sfrwmaker/hakko_t12_stm32/Drivers/README

Extract this archive to the Driver folder. This is a u8g2 library for the project
