sfrwmaker/hakko_t12_stm32/F1-T12.handle.png

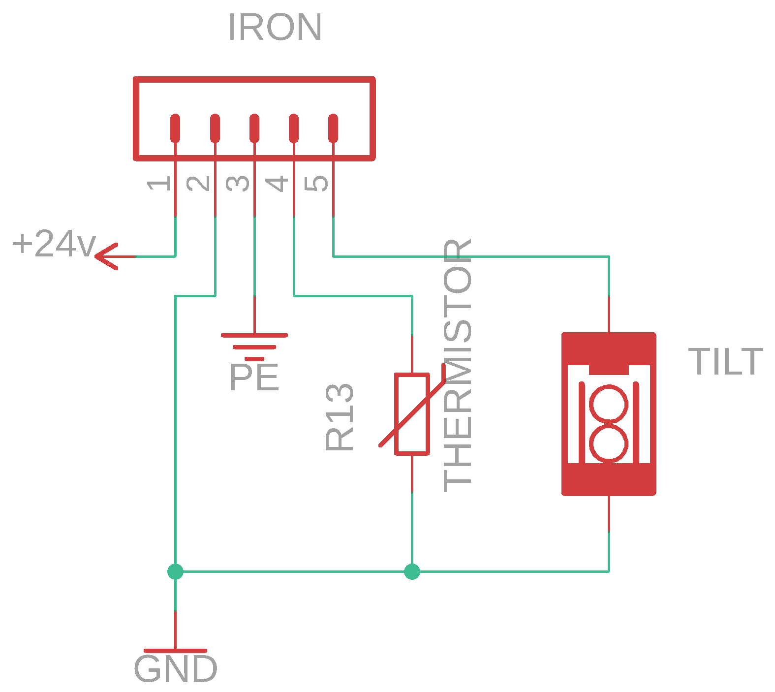
F1-T12.handle.png
