sfrwmaker/hakko_t12_stm32/F1-T12.sensor.png

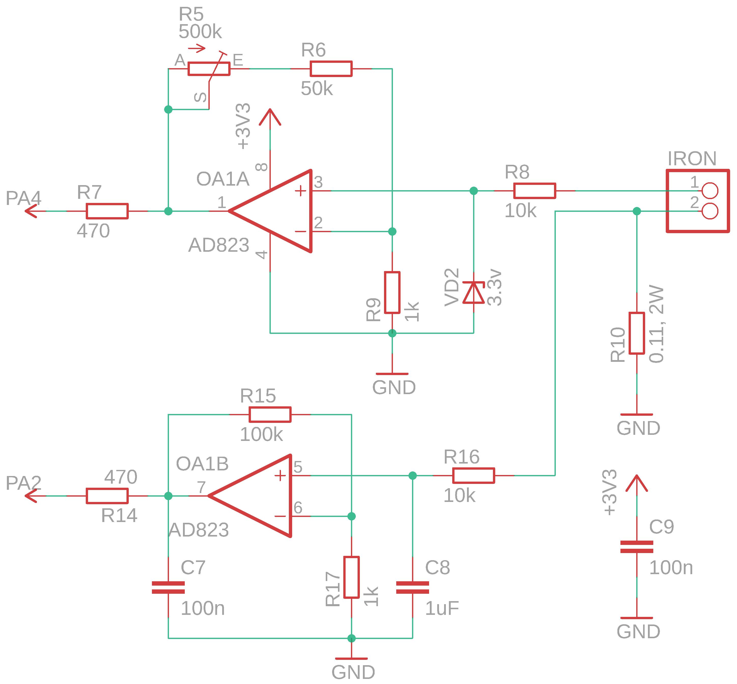
F1-T12.sensor.png
