sfrwmaker/hakko_t12_stm32/F1-T12_nandle.png

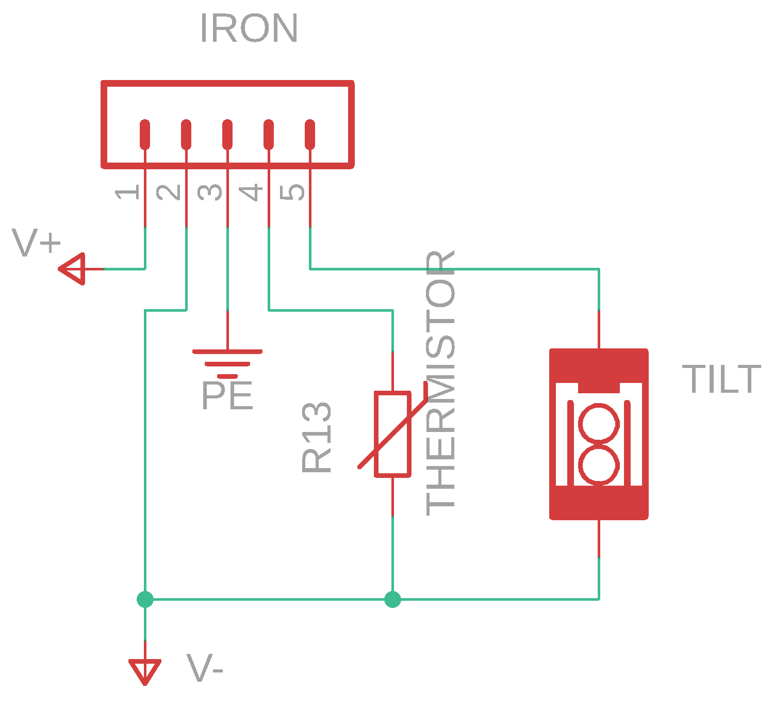
F1-T12_nandle.png
