sfrwmaker/hakko_t12_stm32/F1-T12_sensor.png

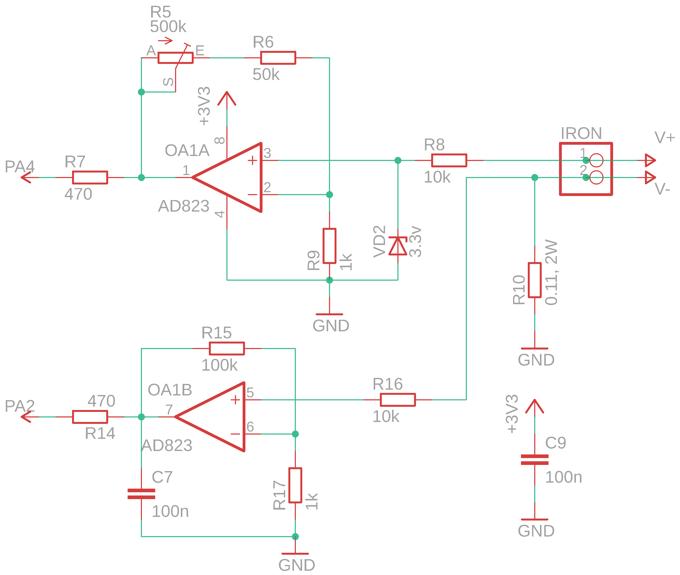
F1-T12_sensor.png
