sfrwmaker/hakko_t12_stm32/v1.0/stm32_hakko_t12_complete.png

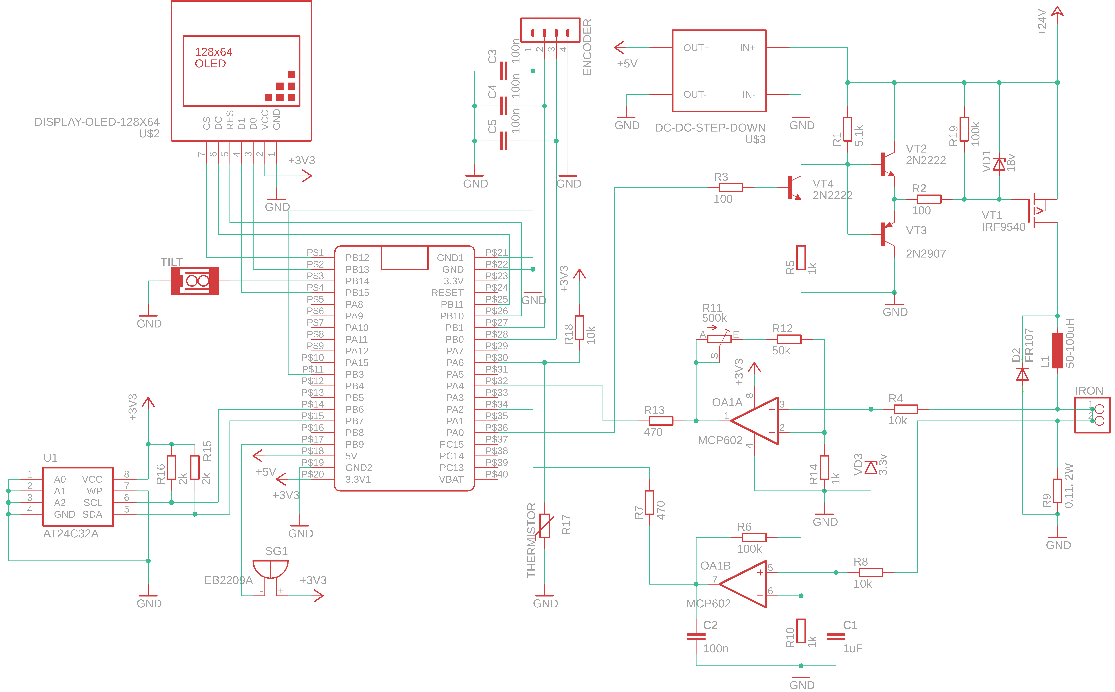
v1.0/stm32_hakko_t12_complete.png
