sfrwmaker/hakko_t12_stm32/(threads)

Thread 1 (2019-01-04):

PCB layout

dodox1, 2019-01-04:
Hello,
do You intend to create/publish PCB for Your project? Can I help with this?

dodo

sfrwmaker, 2019-01-05:
No, i do not intend to create PCB. I would appreciate if you create it.
The main problem is that the schematics is far from ideal one. First, the DC-DC converter should be changed to another one, 24->3.3v and should provide stable power. Second, the op amp should be changed to SMD variant working at 3.3 volts. Finally,  zener diodes vd5 and vd3 should be removed.
As you can see, there are many modification required in the schematics, and  i think it should be prototyped first.

dodox1, 2019-01-05:
Did You see this "china" T12 controller board based on STM32 as inspiration?
There is in a few different HW version (2.1S, 2.01 and 2.0)
Reverse engeniered:
https://github.com/jomat/stm32_soldering_iron_controller/tree/master/schematic

sfrwmaker, 2019-01-05:
Yes, i have one. Cannot tell which version is, but works great. It keeps the preset temperature more accurate than my version, it reaches the temperature faster. I believe, this because of better parameters of PID algorithm. Great, that it has multi-language support. This controller does not use PWM signal to drive the iron, so the schematics is simpler and more compact. Excellent project.
Thank you for the reference.
But this "china" controller has some disadvantages: uses internal clock to show the time (wrongly) and the display is overwhelmed with useless information. The rotary encoder methods are inconvenient: press-and-turn just terrible. There is a red led blinking as iron is powered on.

Thread 2 (2019-01-13):

question about “exponential moving average”

chenli2015, 2019-01-13:
Hi, sfrwmaker,
Thanks for your great work!
Recently, I read your code. I could not understand the “exponential moving average” part.
The following formula is the one get from:
http://www.alglib.net/time-series/moving-average-filter.php
EMA(t) = α·X(t) + (1-α)·EMA(t-1)

but the code from your project is diffrent:
int32_t empAverage(uint32_t *emp_data, uint8_t emp_k, int32_t v) {
  uint8_t round_v = emp_k >> 1;
  *emp_data += v - (*emp_data + round_v) / emp_k;
  return (*emp_data + round_v) / emp_k;
}

Is this a mistake?

sfrwmaker, 2019-01-13:
In the project the recursive variant of the formula is used.

chenli2015, 2019-01-14:
Thanks for your response！ I get the formula from wikipedia.

Closed 2019-01-14.

Thread 3 (2019-12-19):

Recompile, output overflowed

PamiVOV, 2019-12-19:
14:39:16 **** Incremental Build of configuration Release for project F1-T12 ****
make all
arm-none-eabi-g++ -o "F1-T12.elf" @"objects.list"   -mcpu=cortex-m3 -T"../STM32F103C8Tx_FLASH.ld" -Wl,-Map="F1-T12.map" -Wl,--gc-sections -static --specs=nano.specs -mfloat-abi=soft -mthumb -Wl,--start-group -lc -lm -lstdc++ -lsupc++ -Wl,--end-group
c:\st\stm32cubeide_1.0.2\stm32cubeide\plugins\com.st.stm32cube.ide.mcu.externaltools.gnu-tools-for-stm32.7-2018-q2-update.win32_1.0.0.201904181610\tools\arm-none-eabi\bin\ld.exe: F1-T12.elf section `.rodata' will not fit in region `FLASH'
c:\st\stm32cubeide_1.0.2\stm32cubeide\plugins\com.st.stm32cube.ide.mcu.externaltools.gnu-tools-for-stm32.7-2018-q2-update.win32_1.0.0.201904181610\tools\arm-none-eabi\bin\ld.exe: F1-T12.elf section `.bss' will not fit in region `RAM'
c:\st\stm32cubeide_1.0.2\stm32cubeide\plugins\com.st.stm32cube.ide.mcu.externaltools.gnu-tools-for-stm32.7-2018-q2-update.win32_1.0.0.201904181610\tools\arm-none-eabi\bin\ld.exe: region `RAM' overflowed by 115896 bytes
c:\st\stm32cubeide_1.0.2\stm32cubeide\plugins\com.st.stm32cube.ide.mcu.externaltools.gnu-tools-for-stm32.7-2018-q2-update.win32_1.0.0.201904181610\tools\arm-none-eabi\bin\ld.exe: region `FLASH' overflowed by 9253216 bytes
collect2.exe: error: ld returned 1 exit status
make: *** [makefile:60: F1-T12.elf] Error 1
"make all" terminated with exit code 2. Build might be incomplete.

14:39:18 Build Failed. 1 errors, 0 warnings. (took 2s.504ms)

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

sfrwmaker, 2019-12-19:
Optimization options " -ffunction-sections -fdata-sections" should help.
Otherwise, use prebuilt version.

sfrwmaker, 2019-12-19:
Optimization flags should work.

Building file: ../Drivers/u8g2/Src/u8x8_d_lc7981.c
Invoking: MCU GCC Compiler
E:\stm32\F1-T12\Debug
arm-none-eabi-gcc -mcpu=cortex-m3 -mthumb -mfloat-abi=soft '-D__weak=__attribute__((weak))' '-D__packed=__attribute__((__packed__))' -DUSE_HAL_DRIVER -DSTM32F103xB -I"E:/stm32/F1-T12/Inc" -I"E:/stm32/F1-T12/Drivers/u8g2/Inc" -I"E:/stm32/F1-T12/Drivers/STM32F1xx_HAL_Driver/Inc" -I"E:/stm32/F1-T12/Drivers/STM32F1xx_HAL_Driver/Inc/Legacy" -I"E:/stm32/F1-T12/Drivers/CMSIS/Device/ST/STM32F1xx/Include" -I"E:/stm32/F1-T12/Drivers/CMSIS/Include"  -O2 -ffunction-sections -fdata-sections -g3 -Wall -fmessage-length=0 -ffunction-sections -c -fmessage-length=0 -MMD -MP -MF"Drivers/u8g2/Src/u8x8_d_lc7981.d" -MT"Drivers/u8g2/Src/u8x8_d_lc7981.o" -o "Drivers/u8g2/Src/u8x8_d_lc7981.o" "../Drivers/u8g2/Src/u8x8_d_lc7981.c"
Finished building: ../Drivers/u8g2/Src/u8x8_d_lc7981.c

Building file: ../Drivers/u8g2/Src/u8x8_d_ld7032_60x32.c
Invoking: MCU GCC Compiler
E:\stm32\F1-T12\Debug
arm-none-eabi-gcc -mcpu=cortex-m3 -mthumb -mfloat-abi=soft '-D__weak=__attribute__((weak))' '-D__packed=__attribute__((__packed__))' -DUSE_HAL_DRIVER -DSTM32F103xB -I"E:/stm32/F1-T12/Inc" -I"E:/stm32/F1-T12/Drivers/u8g2/Inc" -I"E:/stm32/F1-T12/Drivers/STM32F1xx_HAL_Driver/Inc" -I"E:/stm32/F1-T12/Drivers/STM32F1xx_HAL_Driver/Inc/Legacy" -I"E:/stm32/F1-T12/Drivers/CMSIS/Device/ST/STM32F1xx/Include" -I"E:/stm32/F1-T12/Drivers/CMSIS/Include"  -O2 -ffunction-sections -fdata-sections -g3 -Wall -fmessage-length=0 -ffunction-sections -c -fmessage-length=0 -MMD -MP -MF"Drivers/u8g2/Src/u8x8_d_ld7032_60x32.d" -MT"Drivers/u8g2/Src/u8x8_d_ld7032_60x32.o" -o "Drivers/u8g2/Src/u8x8_d_ld7032_60x32.o" "../Drivers/u8g2/Src/u8x8_d_ld7032_60x32.c"
../Drivers/u8g2/Src/u8x8_d_ld7032_60x32.c:43:22: warning: 'u8x8_d_ld7032_60x32_init_seq_old' defined but not used [-Wunused-const-variable=]
 static const uint8_t u8x8_d_ld7032_60x32_init_seq_old[] = {
                      ^~~~~~~~~~~~~~~~~~~~~~~~~~~~~~~~
Finished building: ../Drivers/u8g2/Src/u8x8_d_ld7032_60x32.c

Building file: ../Drivers/u8g2/Src/u8x8_d_ls013b7dh03.c
Invoking: MCU GCC Compiler
E:\stm32\F1-T12\Debug
arm-none-eabi-gcc -mcpu=cortex-m3 -mthumb -mfloat-abi=soft '-D__weak=__attribute__((weak))' '-D__packed=__attribute__((__packed__))' -DUSE_HAL_DRIVER -DSTM32F103xB -I"E:/stm32/F1-T12/Inc" -I"E:/stm32/F1-T12/Drivers/u8g2/Inc" -I"E:/stm32/F1-T12/Drivers/STM32F1xx_HAL_Driver/Inc" -I"E:/stm32/F1-T12/Drivers/STM32F1xx_HAL_Driver/Inc/Legacy" -I"E:/stm32/F1-T12/Drivers/CMSIS/Device/ST/STM32F1xx/Include" -I"E:/stm32/F1-T12/Drivers/CMSIS/Include"  -O2 -ffunction-sections -fdata-sections -g3 -Wall -fmessage-length=0 -ffunction-sections -c -fmessage-length=0 -MMD -MP -MF"Drivers/u8g2/Src/u8x8_d_ls013b7dh03.d" -MT"Drivers/u8g2/Src/u8x8_d_ls013b7dh03.o" -o "Drivers/u8g2/Src/u8x8_d_ls013b7dh03.o" "../Drivers/u8g2/Src/u8x8_d_ls013b7dh03.c"
Finished building: ../Drivers/u8g2/Src/u8x8_d_ls013b7dh03.c

Building file: ../Drivers/u8g2/Src/u8x8_d_max7219.c
Invoking: MCU GCC Compiler
E:\stm32\F1-T12\Debug
arm-none-eabi-gcc -mcpu=cortex-m3 -mthumb -mfloat-abi=soft '-D__weak=__attribute__((weak))' '-D__packed=__attribute__((__packed__))' -DUSE_HAL_DRIVER -DSTM32F103xB -I"E:/stm32/F1-T12/Inc" -I"E:/stm32/F1-T12/Drivers/u8g2/Inc" -I"E:/stm32/F1-T12/Drivers/STM32F1xx_HAL_Driver/Inc" -I"E:/stm32/F1-T12/Drivers/STM32F1xx_HAL_Driver/Inc/Legacy" -I"E:/stm32/F1-T12/Drivers/CMSIS/Device/ST/STM32F1xx/Include" -I"E:/stm32/F1-T12/Drivers/CMSIS/Include"  -O2 -ffunction-sections -fdata-sections -g3 -Wall -fmessage-length=0 -ffunction-sections -c -fmessage-length=0 -MMD -MP -MF"Drivers/u8g2/Src/u8x8_d_max7219.d" -MT"Drivers/u8g2/Src/u8x8_d_max7219.o" -o "Drivers/u8g2/Src/u8x8_d_max7219.o" "../Drivers/u8g2/Src/u8x8_d_max7219.c"
Finished building: ../Drivers/u8g2/Src/u8x8_d_max7219.c

Building file: ../Drivers/u8g2/Src/u8x8_d_pcd8544_84x48.c
Invoking: MCU GCC Compiler
E:\stm32\F1-T12\Debug
arm-none-eabi-gcc -mcpu=cortex-m3 -mthumb -mfloat-abi=soft '-D__weak=__attribute__((weak))' '-D__packed=__attribute__((__packed__))' -DUSE_HAL_DRIVER -DSTM32F103xB -I"E:/stm32/F1-T12/Inc" -I"E:/stm32/F1-T12/Drivers/u8g2/Inc" -I"E:/stm32/F1-T12/Drivers/STM32F1xx_HAL_Driver/Inc" -I"E:/stm32/F1-T12/Drivers/STM32F1xx_HAL_Driver/Inc/Legacy" -I"E:/stm32/F1-T12/Drivers/CMSIS/Device/ST/STM32F1xx/Include" -I"E:/stm32/F1-T12/Drivers/CMSIS/Include"  -O2 -ffunction-sections -fdata-sections -g3 -Wall -fmessage-length=0 -ffunction-sections -c -fmessage-length=0 -MMD -MP -MF"Drivers/u8g2/Src/u8x8_d_pcd8544_84x48.d" -MT"Drivers/u8g2/Src/u8x8_d_pcd8544_84x48.o" -o "Drivers/u8g2/Src/u8x8_d_pcd8544_84x48.o" "../Drivers/u8g2/Src/u8x8_d_pcd8544_84x48.c"
Finished building: ../Drivers/u8g2/Src/u8x8_d_pcd8544_84x48.c

Building file: ../Drivers/u8g2/Src/u8x8_d_pcf8812.c
Invoking: MCU GCC Compiler
E:\stm32\F1-T12\Debug
arm-none-eabi-gcc -mcpu=cortex-m3 -mthumb -mfloat-abi=soft '-D__weak=__attribute__((weak))' '-D__packed=__attribute__((__packed__))' -DUSE_HAL_DRIVER -DSTM32F103xB -I"E:/stm32/F1-T12/Inc" -I"E:/stm32/F1-T12/Drivers/u8g2/Inc" -I"E:/stm32/F1-T12/Drivers/STM32F1xx_HAL_Driver/Inc" -I"E:/stm32/F1-T12/Drivers/STM32F1xx_HAL_Driver/Inc/Legacy" -I"E:/stm32/F1-T12/Drivers/CMSIS/Device/ST/STM32F1xx/Include" -I"E:/stm32/F1-T12/Drivers/CMSIS/Include"  -O2 -ffunction-sections -fdata-sections -g3 -Wall -fmessage-length=0 -ffunction-sections -c -fmessage-length=0 -MMD -MP -MF"Drivers/u8g2/Src/u8x8_d_pcf8812.d" -MT"Drivers/u8g2/Src/u8x8_d_pcf8812.o" -o "Drivers/u8g2/Src/u8x8_d_pcf8812.o" "../Drivers/u8g2/Src/u8x8_d_pcf8812.c"
Finished building: ../Drivers/u8g2/Src/u8x8_d_pcf8812.c

Building file: ../Drivers/u8g2/Src/u8x8_d_pcf8814_hx1230.c
Invoking: MCU GCC Compiler
E:\stm32\F1-T12\Debug
arm-none-eabi-gcc -mcpu=cortex-m3 -mthumb -mfloat-abi=soft '-D__weak=__attribute__((weak))' '-D__packed=__attribute__((__packed__))' -DUSE_HAL_DRIVER -DSTM32F103xB -I"E:/stm32/F1-T12/Inc" -I"E:/stm32/F1-T12/Drivers/u8g2/Inc" -I"E:/stm32/F1-T12/Drivers/STM32F1xx_HAL_Driver/Inc" -I"E:/stm32/F1-T12/Drivers/STM32F1xx_HAL_Driver/Inc/Legacy" -I"E:/stm32/F1-T12/Drivers/CMSIS/Device/ST/STM32F1xx/Include" -I"E:/stm32/F1-T12/Drivers/CMSIS/Include"  -O2 -ffunction-sections -fdata-sections -g3 -Wall -fmessage-length=0 -ffunction-sections -c -fmessage-length=0 -MMD -MP -MF"Drivers/u8g2/Src/u8x8_d_pcf8814_hx1230.d" -MT"Drivers/u8g2/Src/u8x8_d_pcf8814_hx1230.o" -o "Drivers/u8g2/Src/u8x8_d_pcf8814_hx1230.o" "../Drivers/u8g2/Src/u8x8_d_pcf8814_hx1230.c"
Finished building: ../Drivers/u8g2/Src/u8x8_d_pcf8814_hx1230.c

Building file: ../Drivers/u8g2/Src/u8x8_d_sbn1661.c
Invoking: MCU GCC Compiler
E:\stm32\F1-T12\Debug
arm-none-eabi-gcc -mcpu=cortex-m3 -mthumb -mfloat-abi=soft '-D__weak=__attribute__((weak))' '-D__packed=__attribute__((__packed__))' -DUSE_HAL_DRIVER -DSTM32F103xB -I"E:/stm32/F1-T12/Inc" -I"E:/stm32/F1-T12/Drivers/u8g2/Inc" -I"E:/stm32/F1-T12/Drivers/STM32F1xx_HAL_Driver/Inc" -I"E:/stm32/F1-T12/Drivers/STM32F1xx_HAL_Driver/Inc/Legacy" -I"E:/stm32/F1-T12/Drivers/CMSIS/Device/ST/STM32F1xx/Include" -I"E:/stm32/F1-T12/Drivers/CMSIS/Include"  -O2 -ffunction-sections -fdata-sections -g3 -Wall -fmessage-length=0 -ffunction-sections -c -fmessage-length=0 -MMD -MP -MF"Drivers/u8g2/Src/u8x8_d_sbn1661.d" -MT"Drivers/u8g2/Src/u8x8_d_sbn1661.o" -o "Drivers/u8g2/Src/u8x8_d_sbn1661.o" "../Drivers/u8g2/Src/u8x8_d_sbn1661.c"
Finished building: ../Drivers/u8g2/Src/u8x8_d_sbn1661.c

Building file: ../Drivers/u8g2/Src/u8x8_d_sed1330.c
Invoking: MCU GCC Compiler
E:\stm32\F1-T12\Debug
arm-none-eabi-gcc -mcpu=cortex-m3 -mthumb -mfloat-abi=soft '-D__weak=__attribute__((weak))' '-D__packed=__attribute__((__packed__))' -DUSE_HAL_DRIVER -DSTM32F103xB -I"E:/stm32/F1-T12/Inc" -I"E:/stm32/F1-T12/Drivers/u8g2/Inc" -I"E:/stm32/F1-T12/Drivers/STM32F1xx_HAL_Driver/Inc" -I"E:/stm32/F1-T12/Drivers/STM32F1xx_HAL_Driver/Inc/Legacy" -I"E:/stm32/F1-T12/Drivers/CMSIS/Device/ST/STM32F1xx/Include" -I"E:/stm32/F1-T12/Drivers/CMSIS/Include"  -O2 -ffunction-sections -fdata-sections -g3 -Wall -fmessage-length=0 -ffunction-sections -c -fmessage-length=0 -MMD -MP -MF"Drivers/u8g2/Src/u8x8_d_sed1330.d" -MT"Drivers/u8g2/Src/u8x8_d_sed1330.o" -o "Drivers/u8g2/Src/u8x8_d_sed1330.o" "../Drivers/u8g2/Src/u8x8_d_sed1330.c"
Finished building: ../Drivers/u8g2/Src/u8x8_d_sed1330.c

Building file: ../Drivers/u8g2/Src/u8x8_d_sh1106_64x32.c
Invoking: MCU GCC Compiler
E:\stm32\F1-T12\Debug
arm-none-eabi-gcc -mcpu=cortex-m3 -mthumb -mfloat-abi=soft '-D__weak=__attribute__((weak))' '-D__packed=__attribute__((__packed__))' -DUSE_HAL_DRIVER -DSTM32F103xB -I"E:/stm32/F1-T12/Inc" -I"E:/stm32/F1-T12/Drivers/u8g2/Inc" -I"E:/stm32/F1-T12/Drivers/STM32F1xx_HAL_Driver/Inc" -I"E:/stm32/F1-T12/Drivers/STM32F1xx_HAL_Driver/Inc/Legacy" -I"E:/stm32/F1-T12/Drivers/CMSIS/Device/ST/STM32F1xx/Include" -I"E:/stm32/F1-T12/Drivers/CMSIS/Include"  -O2 -ffunction-sections -fdata-sections -g3 -Wall -fmessage-length=0 -ffunction-sections -c -fmessage-length=0 -MMD -MP -MF"Drivers/u8g2/Src/u8x8_d_sh1106_64x32.d" -MT"Drivers/u8g2/Src/u8x8_d_sh1106_64x32.o" -o "Drivers/u8g2/Src/u8x8_d_sh1106_64x32.o" "../Drivers/u8g2/Src/u8x8_d_sh1106_64x32.c"
Finished building: ../Drivers/u8g2/Src/u8x8_d_sh1106_64x32.c

Building file: ../Drivers/u8g2/Src/u8x8_d_sh1106_72x40.c
Invoking: MCU GCC Compiler
E:\stm32\F1-T12\Debug
arm-none-eabi-gcc -mcpu=cortex-m3 -mthumb -mfloat-abi=soft '-D__weak=__attribute__((weak))' '-D__packed=__attribute__((__packed__))' -DUSE_HAL_DRIVER -DSTM32F103xB -I"E:/stm32/F1-T12/Inc" -I"E:/stm32/F1-T12/Drivers/u8g2/Inc" -I"E:/stm32/F1-T12/Drivers/STM32F1xx_HAL_Driver/Inc" -I"E:/stm32/F1-T12/Drivers/STM32F1xx_HAL_Driver/Inc/Legacy" -I"E:/stm32/F1-T12/Drivers/CMSIS/Device/ST/STM32F1xx/Include" -I"E:/stm32/F1-T12/Drivers/CMSIS/Include"  -O2 -ffunction-sections -fdata-sections -g3 -Wall -fmessage-length=0 -ffunction-sections -c -fmessage-length=0 -MMD -MP -MF"Drivers/u8g2/Src/u8x8_d_sh1106_72x40.d" -MT"Drivers/u8g2/Src/u8x8_d_sh1106_72x40.o" -o "Drivers/u8g2/Src/u8x8_d_sh1106_72x40.o" "../Drivers/u8g2/Src/u8x8_d_sh1106_72x40.c"
Finished building: ../Drivers/u8g2/Src/u8x8_d_sh1106_72x40.c

Building file: ../Drivers/u8g2/Src/u8x8_d_sh1107.c
Invoking: MCU GCC Compiler
E:\stm32\F1-T12\Debug
arm-none-eabi-gcc -mcpu=cortex-m3 -mthumb -mfloat-abi=soft '-D__weak=__attribute__((weak))' '-D__packed=__attribute__((__packed__))' -DUSE_HAL_DRIVER -DSTM32F103xB -I"E:/stm32/F1-T12/Inc" -I"E:/stm32/F1-T12/Drivers/u8g2/Inc" -I"E:/stm32/F1-T12/Drivers/STM32F1xx_HAL_Driver/Inc" -I"E:/stm32/F1-T12/Drivers/STM32F1xx_HAL_Driver/Inc/Legacy" -I"E:/stm32/F1-T12/Drivers/CMSIS/Device/ST/STM32F1xx/Include" -I"E:/stm32/F1-T12/Drivers/CMSIS/Include"  -O2 -ffunction-sections -fdata-sections -g3 -Wall -fmessage-length=0 -ffunction-sections -c -fmessage-length=0 -MMD -MP -MF"Drivers/u8g2/Src/u8x8_d_sh1107.d" -MT"Drivers/u8g2/Src/u8x8_d_sh1107.o" -o "Drivers/u8g2/Src/u8x8_d_sh1107.o" "../Drivers/u8g2/Src/u8x8_d_sh1107.c"
Finished building: ../Drivers/u8g2/Src/u8x8_d_sh1107.c

Building file: ../Drivers/u8g2/Src/u8x8_d_sh1108.c
Invoking: MCU GCC Compiler
E:\stm32\F1-T12\Debug
arm-none-eabi-gcc -mcpu=cortex-m3 -mthumb -mfloat-abi=soft '-D__weak=__attribute__((weak))' '-D__packed=__attribute__((__packed__))' -DUSE_HAL_DRIVER -DSTM32F103xB -I"E:/stm32/F1-T12/Inc" -I"E:/stm32/F1-T12/Drivers/u8g2/Inc" -I"E:/stm32/F1-T12/Drivers/STM32F1xx_HAL_Driver/Inc" -I"E:/stm32/F1-T12/Drivers/STM32F1xx_HAL_Driver/Inc/Legacy" -I"E:/stm32/F1-T12/Drivers/CMSIS/Device/ST/STM32F1xx/Include" -I"E:/stm32/F1-T12/Drivers/CMSIS/Include"  -O2 -ffunction-sections -fdata-sections -g3 -Wall -fmessage-length=0 -ffunction-sections -c -fmessage-length=0 -MMD -MP -MF"Drivers/u8g2/Src/u8x8_d_sh1108.d" -MT"Drivers/u8g2/Src/u8x8_d_sh1108.o" -o "Drivers/u8g2/Src/u8x8_d_sh1108.o" "../Drivers/u8g2/Src/u8x8_d_sh1108.c"
Finished building: ../Drivers/u8g2/Src/u8x8_d_sh1108.c

Building file: ../Drivers/u8g2/Src/u8x8_d_sh1122.c
Invoking: MCU GCC Compiler
E:\stm32\F1-T12\Debug
arm-none-eabi-gcc -mcpu=cortex-m3 -mthumb -mfloat-abi=soft '-D__weak=__attribute__((weak))' '-D__packed=__attribute__((__packed__))' -DUSE_HAL_DRIVER -DSTM32F103xB -I"E:/stm32/F1-T12/Inc" -I"E:/stm32/F1-T12/Drivers/u8g2/Inc" -I"E:/stm32/F1-T12/Drivers/STM32F1xx_HAL_Driver/Inc" -I"E:/stm32/F1-T12/Drivers/STM32F1xx_HAL_Driver/Inc/Legacy" -I"E:/stm32/F1-T12/Drivers/CMSIS/Device/ST/STM32F1xx/Include" -I"E:/stm32/F1-T12/Drivers/CMSIS/Include"  -O2 -ffunction-sections -fdata-sections -g3 -Wall -fmessage-length=0 -ffunction-sections -c -fmessage-length=0 -MMD -MP -MF"Drivers/u8g2/Src/u8x8_d_sh1122.d" -MT"Drivers/u8g2/Src/u8x8_d_sh1122.o" -o "Drivers/u8g2/Src/u8x8_d_sh1122.o" "../Drivers/u8g2/Src/u8x8_d_sh1122.c"
Finished building: ../Drivers/u8g2/Src/u8x8_d_sh1122.c

Building file: ../Drivers/u8g2/Src/u8x8_d_ssd1305.c
Invoking: MCU GCC Compiler
E:\stm32\F1-T12\Debug
arm-none-eabi-gcc -mcpu=cortex-m3 -mthumb -mfloat-abi=soft '-D__weak=__attribute__((weak))' '-D__packed=__attribute__((__packed__))' -DUSE_HAL_DRIVER -DSTM32F103xB -I"E:/stm32/F1-T12/Inc" -I"E:/stm32/F1-T12/Drivers/u8g2/Inc" -I"E:/stm32/F1-T12/Drivers/STM32F1xx_HAL_Driver/Inc" -I"E:/stm32/F1-T12/Drivers/STM32F1xx_HAL_Driver/Inc/Legacy" -I"E:/stm32/F1-T12/Drivers/CMSIS/Device/ST/STM32F1xx/Include" -I"E:/stm32/F1-T12/Drivers/CMSIS/Include"  -O2 -ffunction-sections -fdata-sections -g3 -Wall -fmessage-length=0 -ffunction-sections -c -fmessage-length=0 -MMD -MP -MF"Drivers/u8g2/Src/u8x8_d_ssd1305.d" -MT"Drivers/u8g2/Src/u8x8_d_ssd1305.o" -o "Drivers/u8g2/Src/u8x8_d_ssd1305.o" "../Drivers/u8g2/Src/u8x8_d_ssd1305.c"
Finished building: ../Drivers/u8g2/Src/u8x8_d_ssd1305.c

Building file: ../Drivers/u8g2/Src/u8x8_d_ssd1306_128x32.c
Invoking: MCU GCC Compiler
E:\stm32\F1-T12\Debug
arm-none-eabi-gcc -mcpu=cortex-m3 -mthumb -mfloat-abi=soft '-D__weak=__attribute__((weak))' '-D__packed=__attribute__((__packed__))' -DUSE_HAL_DRIVER -DSTM32F103xB -I"E:/stm32/F1-T12/Inc" -I"E:/stm32/F1-T12/Drivers/u8g2/Inc" -I"E:/stm32/F1-T12/Drivers/STM32F1xx_HAL_Driver/Inc" -I"E:/stm32/F1-T12/Drivers/STM32F1xx_HAL_Driver/Inc/Legacy" -I"E:/stm32/F1-T12/Drivers/CMSIS/Device/ST/STM32F1xx/Include" -I"E:/stm32/F1-T12/Drivers/CMSIS/Include"  -O2 -ffunction-sections -fdata-sections -g3 -Wall -fmessage-length=0 -ffunction-sections -c -fmessage-length=0 -MMD -MP -MF"Drivers/u8g2/Src/u8x8_d_ssd1306_128x32.d" -MT"Drivers/u8g2/Src/u8x8_d_ssd1306_128x32.o" -o "Drivers/u8g2/Src/u8x8_d_ssd1306_128x32.o" "../Drivers/u8g2/Src/u8x8_d_ssd1306_128x32.c"
Finished building: ../Drivers/u8g2/Src/u8x8_d_ssd1306_128x32.c

Building file: ../Drivers/u8g2/Src/u8x8_d_ssd1306_128x64_noname.c
Invoking: MCU GCC Compiler
E:\stm32\F1-T12\Debug
arm-none-eabi-gcc -mcpu=cortex-m3 -mthumb -mfloat-abi=soft '-D__weak=__attribute__((weak))' '-D__packed=__attribute__((__packed__))' -DUSE_HAL_DRIVER -DSTM32F103xB -I"E:/stm32/F1-T12/Inc" -I"E:/stm32/F1-T12/Drivers/u8g2/Inc" -I"E:/stm32/F1-T12/Drivers/STM32F1xx_HAL_Driver/Inc" -I"E:/stm32/F1-T12/Drivers/STM32F1xx_HAL_Driver/Inc/Legacy" -I"E:/stm32/F1-T12/Drivers/CMSIS/Device/ST/STM32F1xx/Include" -I"E:/stm32/F1-T12/Drivers/CMSIS/Include"  -O2 -ffunction-sections -fdata-sections -g3 -Wall -fmessage-length=0 -ffunction-sections -c -fmessage-length=0 -MMD -MP -MF"Drivers/u8g2/Src/u8x8_d_ssd1306_128x64_noname.d" -MT"Drivers/u8g2/Src/u8x8_d_ssd1306_128x64_noname.o" -o "Drivers/u8g2/Src/u8x8_d_ssd1306_128x64_noname.o" "../Drivers/u8g2/Src/u8x8_d_ssd1306_128x64_noname.c"
Finished building: ../Drivers/u8g2/Src/u8x8_d_ssd1306_128x64_noname.c

Building file: ../Drivers/u8g2/Src/u8x8_d_ssd1306_48x64.c
Invoking: MCU GCC Compiler
E:\stm32\F1-T12\Debug
arm-none-eabi-gcc -mcpu=cortex-m3 -mthumb -mfloat-abi=soft '-D__weak=__attribute__((weak))' '-D__packed=__attribute__((__packed__))' -DUSE_HAL_DRIVER -DSTM32F103xB -I"E:/stm32/F1-T12/Inc" -I"E:/stm32/F1-T12/Drivers/u8g2/Inc" -I"E:/stm32/F1-T12/Drivers/STM32F1xx_HAL_Driver/Inc" -I"E:/stm32/F1-T12/Drivers/STM32F1xx_HAL_Driver/Inc/Legacy" -I"E:/stm32/F1-T12/Drivers/CMSIS/Device/ST/STM32F1xx/Include" -I"E:/stm32/F1-T12/Drivers/CMSIS/Include"  -O2 -ffunction-sections -fdata-sections -g3 -Wall -fmessage-length=0 -ffunction-sections -c -fmessage-length=0 -MMD -MP -MF"Drivers/u8g2/Src/u8x8_d_ssd1306_48x64.d" -MT"Drivers/u8g2/Src/u8x8_d_ssd1306_48x64.o" -o "Drivers/u8g2/Src/u8x8_d_ssd1306_48x64.o" "../Drivers/u8g2/Src/u8x8_d_ssd1306_48x64.c"
Finished building: ../Drivers/u8g2/Src/u8x8_d_ssd1306_48x64.c

Building file: ../Drivers/u8g2/Src/u8x8_d_ssd1306_64x32.c
Invoking: MCU GCC Compiler
E:\stm32\F1-T12\Debug
arm-none-eabi-gcc -mcpu=cortex-m3 -mthumb -mfloat-abi=soft '-D__weak=__attribute__((weak))' '-D__packed=__attribute__((__packed__))' -DUSE_HAL_DRIVER -DSTM32F103xB -I"E:/stm32/F1-T12/Inc" -I"E:/stm32/F1-T12/Drivers/u8g2/Inc" -I"E:/stm32/F1-T12/Drivers/STM32F1xx_HAL_Driver/Inc" -I"E:/stm32/F1-T12/Drivers/STM32F1xx_HAL_Driver/Inc/Legacy" -I"E:/stm32/F1-T12/Drivers/CMSIS/Device/ST/STM32F1xx/Include" -I"E:/stm32/F1-T12/Drivers/CMSIS/Include"  -O2 -ffunction-sections -fdata-sections -g3 -Wall -fmessage-length=0 -ffunction-sections -c -fmessage-length=0 -MMD -MP -MF"Drivers/u8g2/Src/u8x8_d_ssd1306_64x32.d" -MT"Drivers/u8g2/Src/u8x8_d_ssd1306_64x32.o" -o "Drivers/u8g2/Src/u8x8_d_ssd1306_64x32.o" "../Drivers/u8g2/Src/u8x8_d_ssd1306_64x32.c"
Finished building: ../Drivers/u8g2/Src/u8x8_d_ssd1306_64x32.c

Building file: ../Drivers/u8g2/Src/u8x8_d_ssd1306_64x48.c
Invoking: MCU GCC Compiler
E:\stm32\F1-T12\Debug
arm-none-eabi-gcc -mcpu=cortex-m3 -mthumb -mfloat-abi=soft '-D__weak=__attribute__((weak))' '-D__packed=__attribute__((__packed__))' -DUSE_HAL_DRIVER -DSTM32F103xB -I"E:/stm32/F1-T12/Inc" -I"E:/stm32/F1-T12/Drivers/u8g2/Inc" -I"E:/stm32/F1-T12/Drivers/STM32F1xx_HAL_Driver/Inc" -I"E:/stm32/F1-T12/Drivers/STM32F1xx_HAL_Driver/Inc/Legacy" -I"E:/stm32/F1-T12/Drivers/CMSIS/Device/ST/STM32F1xx/Include" -I"E:/stm32/F1-T12/Drivers/CMSIS/Include"  -O2 -ffunction-sections -fdata-sections -g3 -Wall -fmessage-length=0 -ffunction-sections -c -fmessage-length=0 -MMD -MP -MF"Drivers/u8g2/Src/u8x8_d_ssd1306_64x48.d" -MT"Drivers/u8g2/Src/u8x8_d_ssd1306_64x48.o" -o "Drivers/u8g2/Src/u8x8_d_ssd1306_64x48.o" "../Drivers/u8g2/Src/u8x8_d_ssd1306_64x48.c"
Finished building: ../Drivers/u8g2/Src/u8x8_d_ssd1306_64x48.c

Building file: ../Drivers/u8g2/Src/u8x8_d_ssd1306_96x16.c
Invoking: MCU GCC Compiler
E:\stm32\F1-T12\Debug
arm-none-eabi-gcc -mcpu=cortex-m3 -mthumb -mfloat-abi=soft '-D__weak=__attribute__((weak))' '-D__packed=__attribute__((__packed__))' -DUSE_HAL_DRIVER -DSTM32F103xB -I"E:/stm32/F1-T12/Inc" -I"E:/stm32/F1-T12/Drivers/u8g2/Inc" -I"E:/stm32/F1-T12/Drivers/STM32F1xx_HAL_Driver/Inc" -I"E:/stm32/F1-T12/Drivers/STM32F1xx_HAL_Driver/Inc/Legacy" -I"E:/stm32/F1-T12/Drivers/CMSIS/Device/ST/STM32F1xx/Include" -I"E:/stm32/F1-T12/Drivers/CMSIS/Include"  -O2 -ffunction-sections -fdata-sections -g3 -Wall -fmessage-length=0 -ffunction-sections -c -fmessage-length=0 -MMD -MP -MF"Drivers/u8g2/Src/u8x8_d_ssd1306_96x16.d" -MT"Drivers/u8g2/Src/u8x8_d_ssd1306_96x16.o" -o "Drivers/u8g2/Src/u8x8_d_ssd1306_96x16.o" "../Drivers/u8g2/Src/u8x8_d_ssd1306_96x16.c"
Finished building: ../Drivers/u8g2/Src/u8x8_d_ssd1306_96x16.c

Building file: ../Drivers/u8g2/Src/u8x8_d_ssd1309.c
Invoking: MCU GCC Compiler
E:\stm32\F1-T12\Debug
arm-none-eabi-gcc -mcpu=cortex-m3 -mthumb -mfloat-abi=soft '-D__weak=__attribute__((weak))' '-D__packed=__attribute__((__packed__))' -DUSE_HAL_DRIVER -DSTM32F103xB -I"E:/stm32/F1-T12/Inc" -I"E:/stm32/F1-T12/Drivers/u8g2/Inc" -I"E:/stm32/F1-T12/Drivers/STM32F1xx_HAL_Driver/Inc" -I"E:/stm32/F1-T12/Drivers/STM32F1xx_HAL_Driver/Inc/Legacy" -I"E:/stm32/F1-T12/Drivers/CMSIS/Device/ST/STM32F1xx/Include" -I"E:/stm32/F1-T12/Drivers/CMSIS/Include"  -O2 -ffunction-sections -fdata-sections -g3 -Wall -fmessage-length=0 -ffunction-sections -c -fmessage-length=0 -MMD -MP -MF"Drivers/u8g2/Src/u8x8_d_ssd1309.d" -MT"Drivers/u8g2/Src/u8x8_d_ssd1309.o" -o "Drivers/u8g2/Src/u8x8_d_ssd1309.o" "../Drivers/u8g2/Src/u8x8_d_ssd1309.c"
Finished building: ../Drivers/u8g2/Src/u8x8_d_ssd1309.c

Building file: ../Drivers/u8g2/Src/u8x8_d_ssd1316.c
Invoking: MCU GCC Compiler
E:\stm32\F1-T12\Debug
arm-none-eabi-gcc -mcpu=cortex-m3 -mthumb -mfloat-abi=soft '-D__weak=__attribute__((weak))' '-D__packed=__attribute__((__packed__))' -DUSE_HAL_DRIVER -DSTM32F103xB -I"E:/stm32/F1-T12/Inc" -I"E:/stm32/F1-T12/Drivers/u8g2/Inc" -I"E:/stm32/F1-T12/Drivers/STM32F1xx_HAL_Driver/Inc" -I"E:/stm32/F1-T12/Drivers/STM32F1xx_HAL_Driver/Inc/Legacy" -I"E:/stm32/F1-T12/Drivers/CMSIS/Device/ST/STM32F1xx/Include" -I"E:/stm32/F1-T12/Drivers/CMSIS/Include"  -O2 -ffunction-sections -fdata-sections -g3 -Wall -fmessage-length=0 -ffunction-sections -c -fmessage-length=0 -MMD -MP -MF"Drivers/u8g2/Src/u8x8_d_ssd1316.d" -MT"Drivers/u8g2/Src/u8x8_d_ssd1316.o" -o "Drivers/u8g2/Src/u8x8_d_ssd1316.o" "../Drivers/u8g2/Src/u8x8_d_ssd1316.c"
Finished building: ../Drivers/u8g2/Src/u8x8_d_ssd1316.c

Building file: ../Drivers/u8g2/Src/u8x8_d_ssd1317.c
Invoking: MCU GCC Compiler
E:\stm32\F1-T12\Debug
arm-none-eabi-gcc -mcpu=cortex-m3 -mthumb -mfloat-abi=soft '-D__weak=__attribute__((weak))' '-D__packed=__attribute__((__packed__))' -DUSE_HAL_DRIVER -DSTM32F103xB -I"E:/stm32/F1-T12/Inc" -I"E:/stm32/F1-T12/Drivers/u8g2/Inc" -I"E:/stm32/F1-T12/Drivers/STM32F1xx_HAL_Driver/Inc" -I"E:/stm32/F1-T12/Drivers/STM32F1xx_HAL_Driver/Inc/Legacy" -I"E:/stm32/F1-T12/Drivers/CMSIS/Device/ST/STM32F1xx/Include" -I"E:/stm32/F1-T12/Drivers/CMSIS/Include"  -O2 -ffunction-sections -fdata-sections -g3 -Wall -fmessage-length=0 -ffunction-sections -c -fmessage-length=0 -MMD -MP -MF"Drivers/u8g2/Src/u8x8_d_ssd1317.d" -MT"Drivers/u8g2/Src/u8x8_d_ssd1317.o" -o "Drivers/u8g2/Src/u8x8_d_ssd1317.o" "../Drivers/u8g2/Src/u8x8_d_ssd1317.c"
Finished building: ../Drivers/u8g2/Src/u8x8_d_ssd1317.c

Building file: ../Drivers/u8g2/Src/u8x8_d_ssd1318.c
Invoking: MCU GCC Compiler
E:\stm32\F1-T12\Debug
arm-none-eabi-gcc -mcpu=cortex-m3 -mthumb -mfloat-abi=soft '-D__weak=__attribute__((weak))' '-D__packed=__attribute__((__packed__))' -DUSE_HAL_DRIVER -DSTM32F103xB -I"E:/stm32/F1-T12/Inc" -I"E:/stm32/F1-T12/Drivers/u8g2/Inc" -I"E:/stm32/F1-T12/Drivers/STM32F1xx_HAL_Driver/Inc" -I"E:/stm32/F1-T12/Drivers/STM32F1xx_HAL_Driver/Inc/Legacy" -I"E:/stm32/F1-T12/Drivers/CMSIS/Device/ST/STM32F1xx/Include" -I"E:/stm32/F1-T12/Drivers/CMSIS/Include"  -O2 -ffunction-sections -fdata-sections -g3 -Wall -fmessage-length=0 -ffunction-sections -c -fmessage-length=0 -MMD -MP -MF"Drivers/u8g2/Src/u8x8_d_ssd1318.d" -MT"Drivers/u8g2/Src/u8x8_d_ssd1318.o" -o "Drivers/u8g2/Src/u8x8_d_ssd1318.o" "../Drivers/u8g2/Src/u8x8_d_ssd1318.c"
Finished building: ../Drivers/u8g2/Src/u8x8_d_ssd1318.c

Building file: ../Drivers/u8g2/Src/u8x8_d_ssd1322.c
Invoking: MCU GCC Compiler
E:\stm32\F1-T12\Debug
arm-none-eabi-gcc -mcpu=cortex-m3 -mthumb -mfloat-abi=soft '-D__weak=__attribute__((weak))' '-D__packed=__attribute__((__packed__))' -DUSE_HAL_DRIVER -DSTM32F103xB -I"E:/stm32/F1-T12/Inc" -I"E:/stm32/F1-T12/Drivers/u8g2/Inc" -I"E:/stm32/F1-T12/Drivers/STM32F1xx_HAL_Driver/Inc" -I"E:/stm32/F1-T12/Drivers/STM32F1xx_HAL_Driver/Inc/Legacy" -I"E:/stm32/F1-T12/Drivers/CMSIS/Device/ST/STM32F1xx/Include" -I"E:/stm32/F1-T12/Drivers/CMSIS/Include"  -O2 -ffunction-sections -fdata-sections -g3 -Wall -fmessage-length=0 -ffunction-sections -c -fmessage-length=0 -MMD -MP -MF"Drivers/u8g2/Src/u8x8_d_ssd1322.d" -MT"Drivers/u8g2/Src/u8x8_d_ssd1322.o" -o "Drivers/u8g2/Src/u8x8_d_ssd1322.o" "../Drivers/u8g2/Src/u8x8_d_ssd1322.c"
Finished building: ../Drivers/u8g2/Src/u8x8_d_ssd1322.c

Building file: ../Drivers/u8g2/Src/u8x8_d_ssd1325.c
Invoking: MCU GCC Compiler
E:\stm32\F1-T12\Debug
arm-none-eabi-gcc -mcpu=cortex-m3 -mthumb -mfloat-abi=soft '-D__weak=__attribute__((weak))' '-D__packed=__attribute__((__packed__))' -DUSE_HAL_DRIVER -DSTM32F103xB -I"E:/stm32/F1-T12/Inc" -I"E:/stm32/F1-T12/Drivers/u8g2/Inc" -I"E:/stm32/F1-T12/Drivers/STM32F1xx_HAL_Driver/Inc" -I"E:/stm32/F1-T12/Drivers/STM32F1xx_HAL_Driver/Inc/Legacy" -I"E:/stm32/F1-T12/Drivers/CMSIS/Device/ST/STM32F1xx/Include" -I"E:/stm32/F1-T12/Drivers/CMSIS/Include"  -O2 -ffunction-sections -fdata-sections -g3 -Wall -fmessage-length=0 -ffunction-sections -c -fmessage-length=0 -MMD -MP -MF"Drivers/u8g2/Src/u8x8_d_ssd1325.d" -MT"Drivers/u8g2/Src/u8x8_d_ssd1325.o" -o "Drivers/u8g2/Src/u8x8_d_ssd1325.o" "../Drivers/u8g2/Src/u8x8_d_ssd1325.c"
Finished building: ../Drivers/u8g2/Src/u8x8_d_ssd1325.c

Building file: ../Drivers/u8g2/Src/u8x8_d_ssd1326.c
Invoking: MCU GCC Compiler
E:\stm32\F1-T12\Debug
arm-none-eabi-gcc -mcpu=cortex-m3 -mthumb -mfloat-abi=soft '-D__weak=__attribute__((weak))' '-D__packed=__attribute__((__packed__))' -DUSE_HAL_DRIVER -DSTM32F103xB -I"E:/stm32/F1-T12/Inc" -I"E:/stm32/F1-T12/Drivers/u8g2/Inc" -I"E:/stm32/F1-T12/Drivers/STM32F1xx_HAL_Driver/Inc" -I"E:/stm32/F1-T12/Drivers/STM32F1xx_HAL_Driver/Inc/Legacy" -I"E:/stm32/F1-T12/Drivers/CMSIS/Device/ST/STM32F1xx/Include" -I"E:/stm32/F1-T12/Drivers/CMSIS/Include"  -O2 -ffunction-sections -fdata-sections -g3 -Wall -fmessage-length=0 -ffunction-sections -c -fmessage-length=0 -MMD -MP -MF"Drivers/u8g2/Src/u8x8_d_ssd1326.d" -MT"Drivers/u8g2/Src/u8x8_d_ssd1326.o" -o "Drivers/u8g2/Src/u8x8_d_ssd1326.o" "../Drivers/u8g2/Src/u8x8_d_ssd1326.c"
Finished building: ../Drivers/u8g2/Src/u8x8_d_ssd1326.c

Building file: ../Drivers/u8g2/Src/u8x8_d_ssd1327.c
Invoking: MCU GCC Compiler
E:\stm32\F1-T12\Debug
arm-none-eabi-gcc -mcpu=cortex-m3 -mthumb -mfloat-abi=soft '-D__weak=__attribute__((weak))' '-D__packed=__attribute__((__packed__))' -DUSE_HAL_DRIVER -DSTM32F103xB -I"E:/stm32/F1-T12/Inc" -I"E:/stm32/F1-T12/Drivers/u8g2/Inc" -I"E:/stm32/F1-T12/Drivers/STM32F1xx_HAL_Driver/Inc" -I"E:/stm32/F1-T12/Drivers/STM32F1xx_HAL_Driver/Inc/Legacy" -I"E:/stm32/F1-T12/Drivers/CMSIS/Device/ST/STM32F1xx/Include" -I"E:/stm32/F1-T12/Drivers/CMSIS/Include"  -O2 -ffunction-sections -fdata-sections -g3 -Wall -fmessage-length=0 -ffunction-sections -c -fmessage-length=0 -MMD -MP -MF"Drivers/u8g2/Src/u8x8_d_ssd1327.d" -MT"Drivers/u8g2/Src/u8x8_d_ssd1327.o" -o "Drivers/u8g2/Src/u8x8_d_ssd1327.o" "../Drivers/u8g2/Src/u8x8_d_ssd1327.c"
Finished building: ../Drivers/u8g2/Src/u8x8_d_ssd1327.c

Building file: ../Drivers/u8g2/Src/u8x8_d_ssd1329.c
Invoking: MCU GCC Compiler
E:\stm32\F1-T12\Debug
arm-none-eabi-gcc -mcpu=cortex-m3 -mthumb -mfloat-abi=soft '-D__weak=__attribute__((weak))' '-D__packed=__attribute__((__packed__))' -DUSE_HAL_DRIVER -DSTM32F103xB -I"E:/stm32/F1-T12/Inc" -I"E:/stm32/F1-T12/Drivers/u8g2/Inc" -I"E:/stm32/F1-T12/Drivers/STM32F1xx_HAL_Driver/Inc" -I"E:/stm32/F1-T12/Drivers/STM32F1xx_HAL_Driver/Inc/Legacy" -I"E:/stm32/F1-T12/Drivers/CMSIS/Device/ST/STM32F1xx/Include" -I"E:/stm32/F1-T12/Drivers/CMSIS/Include"  -O2 -ffunction-sections -fdata-sections -g3 -Wall -fmessage-length=0 -ffunction-sections -c -fmessage-length=0 -MMD -MP -MF"Drivers/u8g2/Src/u8x8_d_ssd1329.d" -MT"Drivers/u8g2/Src/u8x8_d_ssd1329.o" -o "Drivers/u8g2/Src/u8x8_d_ssd1329.o" "../Drivers/u8g2/Src/u8x8_d_ssd1329.c"
Finished building: ../Drivers/u8g2/Src/u8x8_d_ssd1329.c

Building file: ../Drivers/u8g2/Src/u8x8_d_ssd1606_172x72.c
Invoking: MCU GCC Compiler
E:\stm32\F1-T12\Debug
arm-none-eabi-gcc -mcpu=cortex-m3 -mthumb -mfloat-abi=soft '-D__weak=__attribute__((weak))' '-D__packed=__attribute__((__packed__))' -DUSE_HAL_DRIVER -DSTM32F103xB -I"E:/stm32/F1-T12/Inc" -I"E:/stm32/F1-T12/Drivers/u8g2/Inc" -I"E:/stm32/F1-T12/Drivers/STM32F1xx_HAL_Driver/Inc" -I"E:/stm32/F1-T12/Drivers/STM32F1xx_HAL_Driver/Inc/Legacy" -I"E:/stm32/F1-T12/Drivers/CMSIS/Device/ST/STM32F1xx/Include" -I"E:/stm32/F1-T12/Drivers/CMSIS/Include"  -O2 -ffunction-sections -fdata-sections -g3 -Wall -fmessage-length=0 -ffunction-sections -c -fmessage-length=0 -MMD -MP -MF"Drivers/u8g2/Src/u8x8_d_ssd1606_172x72.d" -MT"Drivers/u8g2/Src/u8x8_d_ssd1606_172x72.o" -o "Drivers/u8g2/Src/u8x8_d_ssd1606_172x72.o" "../Drivers/u8g2/Src/u8x8_d_ssd1606_172x72.c"
Finished building: ../Drivers/u8g2/Src/u8x8_d_ssd1606_172x72.c

Building file:
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

Thread 4 (2020-05-17):

The temperature stability is not very good

daohuaxiang4, 2020-05-17:
1，Hello, I can not find the ad823 chip with lm358 instead of poor temperature stability after the need to adjust the pid parameters or should use the ad823 chip
2，Some of the cores make noise when they work

sfrwmaker, 2020-05-17:
Hello!
1. l358 is not an analog of ad822. If the lm358 was good for this i would put it itno the schematics, The magic is that lm358 is working like random generator and the controller become instable.
2. Noise will be vanished as soon as you use accurate op-amp. It is a magic. :)

daohuaxiang4, 2020-05-17:
Thank you very much for your answer. I'll try another IC

Thread 5 (2024-01-13):

please add IR Remote control for t12!

myvcgit, 2024-01-13:
i have IR Remote and connect receivers to pb5.
please add IR Remote control for this project.
thank you!!!

the IR Remote can fast change temperature。
if  key 1 set  250 degree ,key 2 set  300 degree,key 3 set 350,key 4 set 400.
press key can fast set 250 to 400 or other.

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
