sfrwmaker/hakko_t12_stm32/eagle/F1-T12_complete.sch

## EAGLE design eagle/F1-T12_complete.sch (2021-02-28)

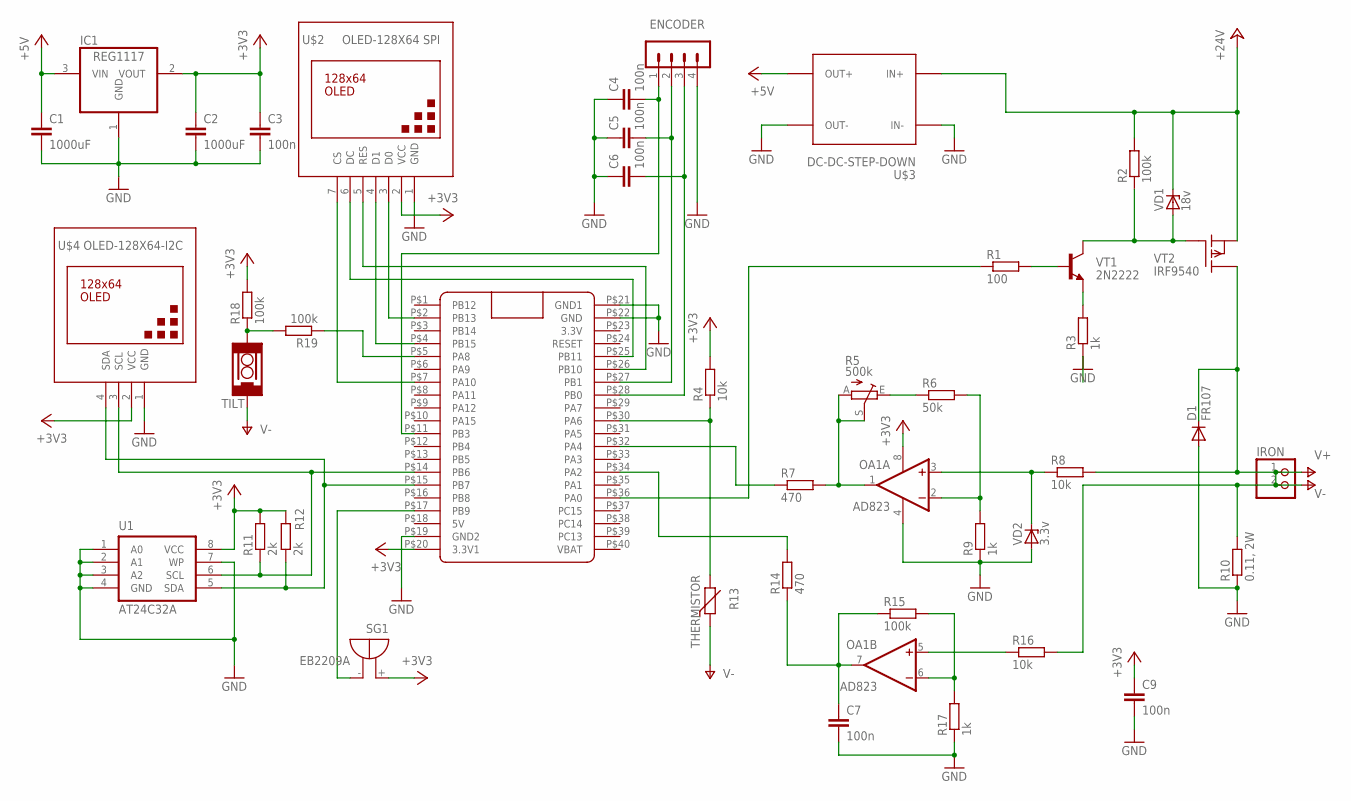
[picture p11: schematic F1-T12_complete.sch]

Parts:
C1, C2: 1000uF; C025-025X050
C3, C4, C5, C6, C7, C9: 100n; C025-025X050
D1: FR107; DO41-10
ENCODER: MA04-1
IC1: REG1117; SOT223
IRON: PINHD-1X2; 1X02
OA1: AD823; SO08
R1: 100; 0204/5
R2, R15, R18, R19: 100k; 0204/5
R3, R9, R17: 1k; 0204/5
R4, R8, R16: 10k; 0204/5
R5: 500k; RJ9W
R6: 50k; 0204/5
R7, R14: 470; 0204/5
R10: 0.11, 2W; 0204/5
R11, R12: 2k; 0204/5
R13: THERMISTOR; RS-2,5
SG1: EB2209A
TILT: SQ-SEN-200
U1: AT24C32A; SO08-8S1
U$1: BLUE_PILL
U$2: OLED-128X64 SPI; DISPLAY-OLED-128X64
U$3: DC-DC-STEP-DOWN; DC-DC-STEP-DOWN-MP2307
U$4: OLED-128X64-I2C; DISPLAY-OLED-128X64-I2C
VD1: 18v; DO34Z7
VD2: 3.3v; DO34Z7
VT1: 2N2222; TO18
VT2: IRF9540; TO220

Connections:
+3V3: C2.1, C3.1, C9.1, IC1.2 (VOUT), OA1.8 (V+), R4.2, R11.2, R12.2, R18.2, SG1.+, U1.8 (VCC), U$1.P$20 (3.3V1), U$2.2 (VCC), U$4.2 (VCC)
+5V: C1.1, IC1.3 (VIN), U$3.OUT+
+24V: R2.2, U$3.IN+, VD1.C, VT2.3 (S)
GND: C1.2, C2.2, C3.2, C4.1, C5.1, C6.1, C7.2, C9.2, D1.A, ENCODER.4, IC1.1 (GND), R3.1, R10.1, R17.1, U1.1 (A0), U1.2 (A1), U1.3 (A2), U1.4 (GND), U1.7 (WP), U$1.P$19 (GND2), U$1.P$21 (GND1), U$1.P$22 (GND), U$2.1 (GND), U$3.IN-, U$3.OUT-, U$4.1 (GND)
unnamed: R12.1, U1.5 (SDA), U$1.P$15 (PB7), U$4.4 (SDA)
unnamed: R11.1, U1.6 (SCL), U$1.P$14 (PB6), U$4.3 (SCL)
unnamed: U$1.P$7 (PA10), U$2.7 (CS)
unnamed: U$1.P$25 (PB11), U$2.6 (DC)
unnamed: U$1.P$26 (PB10), U$2.5 (RES)
unnamed: U$1.P$4 (PB15), U$2.4 (D1)
unnamed: U$1.P$2 (PB13), U$2.3 (D0)
unnamed: SG1.-, U$1.P$17 (PB9)
unnamed: C6.2, ENCODER.3, U$1.P$28 (PB0)
unnamed: C5.2, ENCODER.2, U$1.P$27 (PB1)
unnamed: C4.2, ENCODER.1, U$1.P$11 (PB3)
unnamed: R5.E, R6.1
unnamed: R7.1, U$1.P$32 (PA4)
unnamed: OA1.2 (-IN), R6.2, R9.2
unnamed: OA1.3 (+IN), R8.1, VD2.C
unnamed: R19.1, U$1.P$5 (PA8)
unnamed: C7.1, OA1.7 (OUT), R14.1, R15.1
unnamed: OA1.6 (-IN), R15.2, R17.2
unnamed: OA1.1 (OUT), R5.A, R5.S, R7.2
unnamed: R14.2, U$1.P$34 (PA2)
unnamed: OA1.5 (+IN), R16.1
unnamed: R2.1, VD1.A, VT1.3 (C), VT2.1 (G)
unnamed: R18.1, R19.2, TILT.2
unnamed: R3.2, VT1.1 (E)
unnamed: R1.2, VT1.2 (B)
unnamed: R1.1, U$1.P$36 (PA0)
unnamed: R4.1, R13.2, U$1.P$30 (PA6)
V-: D1.C, IRON.1, IRON.2, R8.2, R10.2, R13.1, R16.2, TILT.1, VT2.2 (D)
VD3: OA1.4 (V-), R9.1, VD2.A
