sfrwmaker/hakko_t12_stm32/eagle/F1-T12_heater.sch

## EAGLE design eagle/F1-T12_heater.sch (2021-02-28)

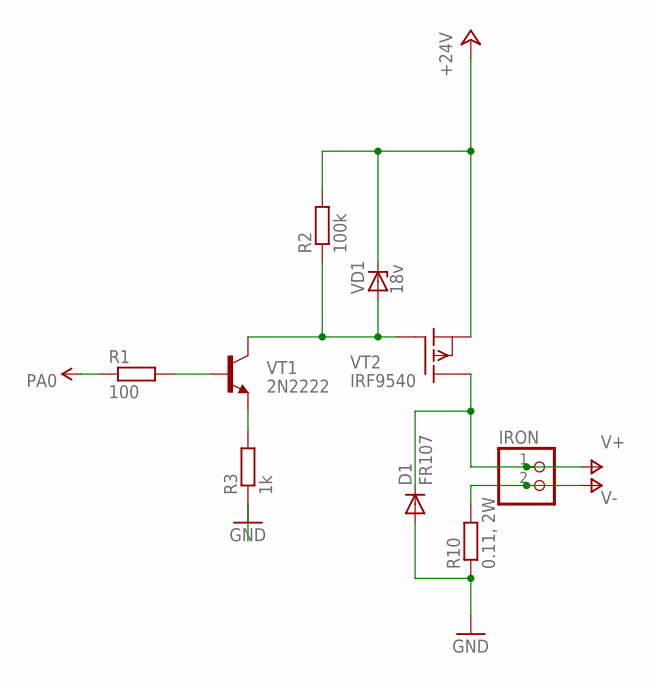
[picture p12: schematic F1-T12_heater.sch]

Parts:
D1: FR107; DO41-10
IRON: PINHD-1X2; 1X02
R1: 100; 0204/5
R2: 100k; 0204/5
R3: 1k; 0204/5
R10: 0.11, 2W; 0204/5
VD1: 18v; DO34Z7
VT1: 2N2222; TO18
VT2: IRF9540; TO220

Connections:
+24V: R2.2, VD1.C, VT2.3 (S)
GND: D1.A, R3.1, R10.1
unnamed: R2.1, VD1.A, VT1.3 (C), VT2.1 (G)
unnamed: R3.2, VT1.1 (E)
unnamed: R1.2, VT1.2 (B)
V+: D1.C, IRON.1, VT2.2 (D)
V-: IRON.2, R10.2
VDD: R1.1
