sfrwmaker/hakko_t12_stm32/eagle/F1-T12_sensor.sch

## EAGLE design eagle/F1-T12_sensor.sch (2021-02-28)

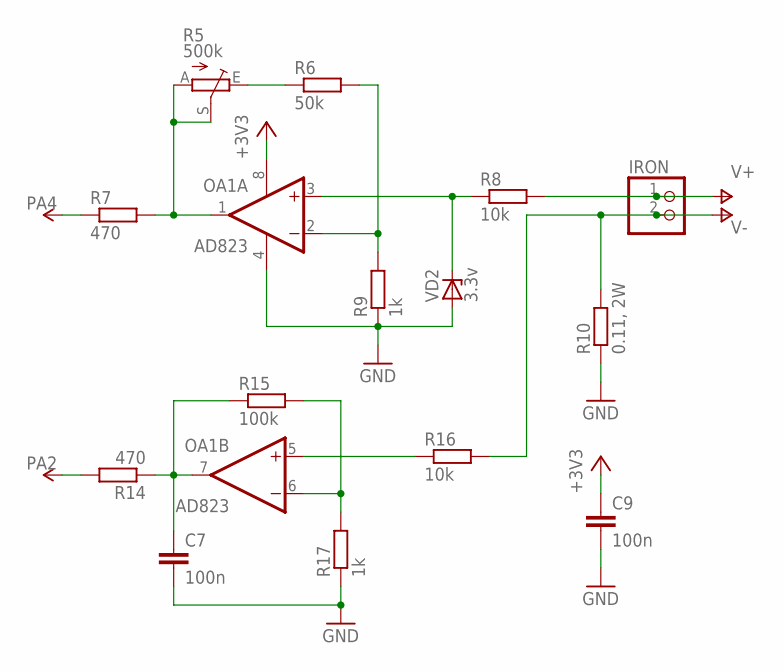
[picture p13: schematic F1-T12_sensor.sch]

Parts:
C7, C9: 100n; C025-025X050
IRON: PINHD-1X2; 1X02
OA1: AD823; SO08
R5: 500k; B64Y
R6: 50k; 0204/5
R7, R14: 470; 0204/5
R8, R16: 10k; 0204/5
R9, R17: 1k; 0204/5
R10: 0.11, 2W; 0204/5
R15: 100k; 0204/5
VD2: 3.3v; DO34Z7

Connections:
+3V3: C9.1, OA1.8 (V+)
GND: C7.2, C9.2, R10.1, R17.1
unnamed: R5.E, R6.1
unnamed: OA1.2 (-IN), R6.2, R9.2
unnamed: OA1.3 (+IN), R8.1, VD2.C
unnamed: C7.1, OA1.7 (OUT), R14.1, R15.1
unnamed: OA1.6 (-IN), R15.2, R17.2
unnamed: OA1.1 (OUT), R5.A, R5.S, R7.2
unnamed: OA1.5 (+IN), R16.1
V+: IRON.1, R8.2
V-: IRON.2, R10.2, R16.2
VCCA: R7.1
VD3: OA1.4 (V-), R9.1, VD2.A
VDD: R14.2
