sfrwmaker/hakko_t12_stm32/eagle/handle.sch

## EAGLE design eagle/handle.sch (2021-02-28)

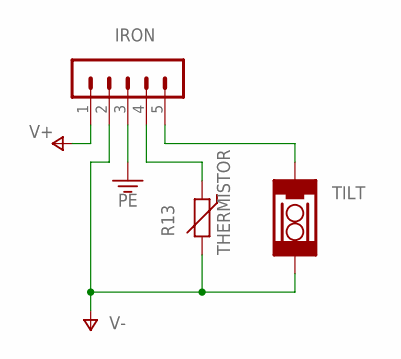
[picture p14: schematic handle.sch]

Parts:
IRON: MA05-1
R13: THERMISTOR; R-5
TILT: SQ-SEN-200

Connections:
3.3V: IRON.3
unnamed: IRON.4, R13.1
unnamed: IRON.5, TILT.1
V+: IRON.1
V-: IRON.2, R13.2, TILT.2
