sfrwmaker/hakko_t12_stm32/v1.0/handle.sch

## EAGLE design v1.0/handle.sch (2019-03-19)

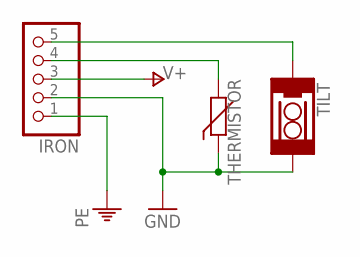
[picture p15: schematic handle.sch]

Parts:
IRON: PINHD-1X5; 1X05
THERMISTOR: THERMISTOR_R-2,5; RS-2,5
TILT: SQ-SEN-200

Connections:
GND: IRON.2, THERMISTOR.1, TILT.2
unnamed: IRON.4, THERMISTOR.2
unnamed: IRON.5, TILT.1
PE: IRON.1
V+: IRON.3
