sfrwmaker/hakko_t12_stm32/v1.0/heater.sch

## EAGLE design v1.0/heater.sch (2019-03-19)

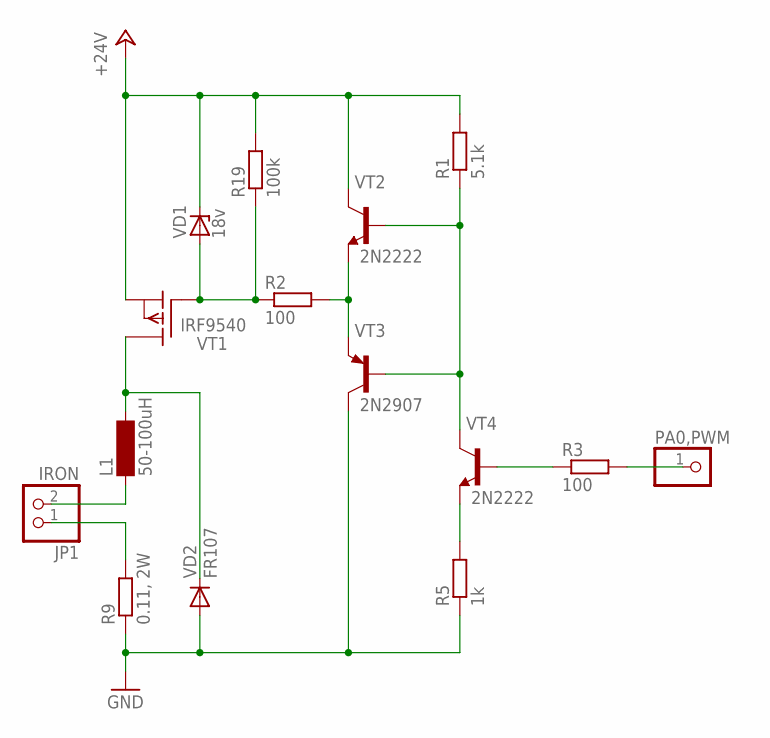
[picture p16: schematic heater.sch]

Parts:
JP1: IRON; 1X02
L1: 50-100uH; SD8
PA0,PWM: PINHD-1X1; 1X01
R1: 5.1k; 0207/10
R2, R3: 100; 0207/10
R5: 1k; 0207/10
R9: 0.11, 2W; 0207/10
R19: 100k; 0207/10
VD1: 18v; C1702-15
VD2: FR107; DO41-10
VT1: IRF9540; TO220
VT2, VT4: 2N2222; TO18
VT3: 2N2907; TO18

Connections:
+24V: R1.2, R19.2, VD1.C, VT1.3 (S), VT2.3 (C)
GND: R5.1, R9.1, VD2.A, VT3.3 (C)
unnamed: JP1.1, R9.2
unnamed: JP1.2, L1.1
unnamed: L1.2, VD2.C, VT1.2 (D)
unnamed: R2.1, R19.1, VD1.A, VT1.1 (G)
unnamed: R2.2, VT2.1 (E), VT3.1 (E)
unnamed: R1.1, VT2.2 (B), VT3.2 (B), VT4.3 (C)
unnamed: R5.2, VT4.1 (E)
unnamed: R3.1, VT4.2 (B)
unnamed: PA0,PWM.1, R3.2
