sfrwmaker/hakko_t12_stm32/v1.0/sensor.sch

## EAGLE design v1.0/sensor.sch (2019-09-21)

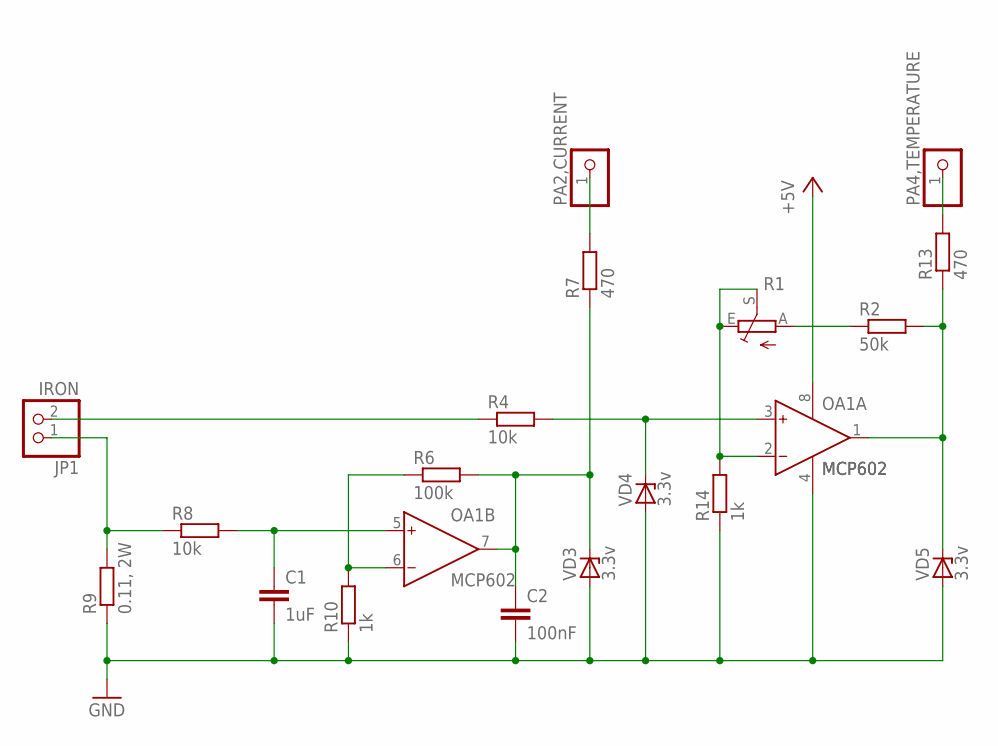
[picture p17: schematic sensor.sch]

Parts:
C1: 1uF; C025-024X044
C2: 100nF; C025-024X044
JP1: IRON; 1X02
OA1: MCP602; DIL08
PA2,CURRENT, PA4,TEMPERATURE: PINHD-1X1; 1X01
R1: TRIM_EU-B64Y; B64Y
R2: 50k; 0204/5
R4, R8: 10k; 0204/5
R6: 100k; 0204/5
R7, R13: 470; 0204/5
R9: 0.11, 2W; 0204/5
R10, R14: 1k; 0204/5
VD3, VD4, VD5: 3.3v; C1702-15

Connections:
+5V: OA1.8 (V+)
GND: C1.2, C2.2, OA1.4 (V-), R9.1, R10.1, R14.1, VD3.A, VD4.A, VD5.A
unnamed: JP1.1, R8.1, R9.2
unnamed: C1.1, OA1.5 (IN+), R8.2
unnamed: OA1.6 (IN-), R6.1, R10.2
unnamed: C2.1, OA1.7 (OUT), R6.2, R7.1, VD3.C
unnamed: OA1.3 (IN+), R4.2, VD4.C
unnamed: OA1.2 (IN-), R1.E, R1.S, R14.2
unnamed: JP1.2, R4.1
unnamed: PA2,CURRENT.1, R7.2
unnamed: PA4,TEMPERATURE.1, R13.2
unnamed: R1.A, R2.1
unnamed: OA1.1 (OUT), R2.2, R13.1, VD5.C
