sfrwmaker/hakko_t12_stm32/v1.0/stm32_hakko.sch

## EAGLE design v1.0/stm32_hakko.sch (2019-03-19)

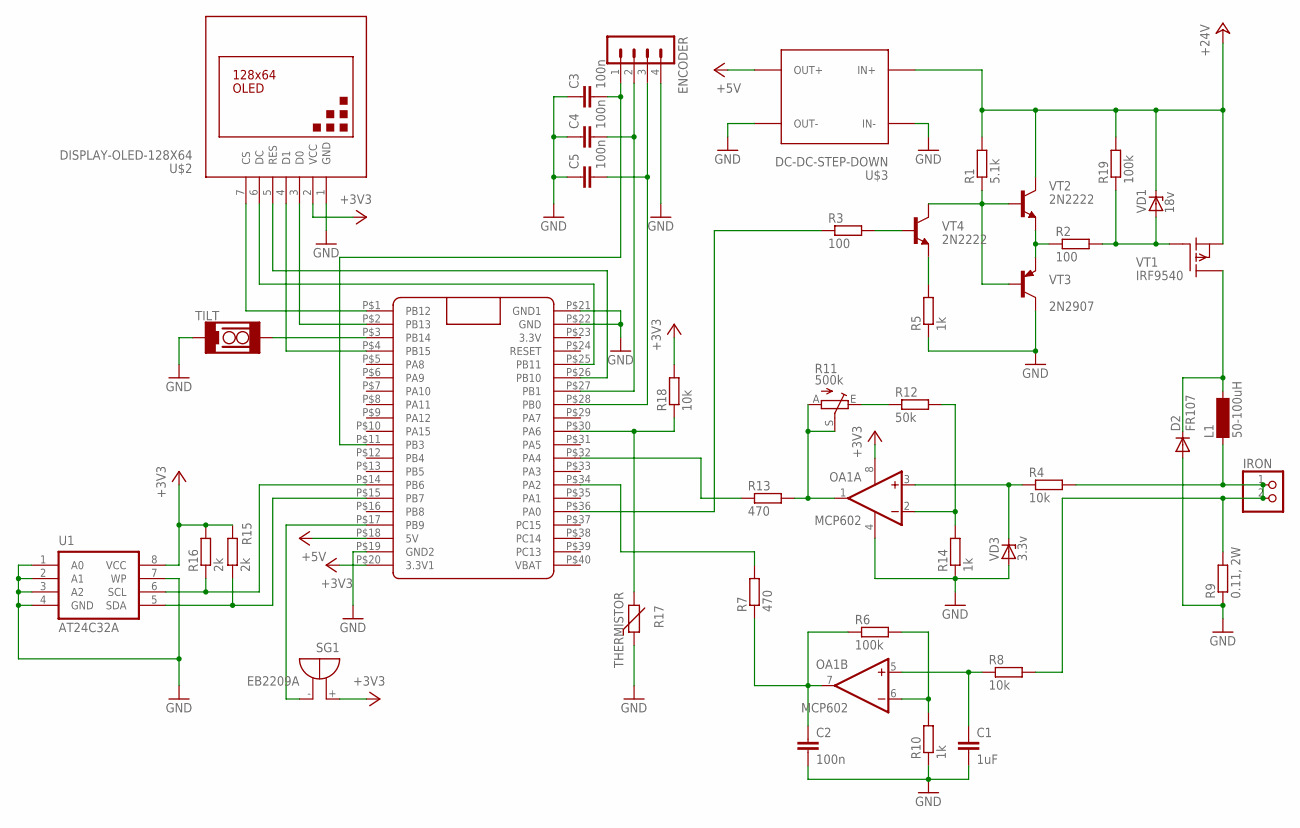
[picture p18: schematic stm32_hakko.sch]

Parts:
C1: 1uF; C025-025X050
C2, C3, C4, C5: 100n; C025-025X050
D2: FR107; DO41-10
ENCODER: MA04-1
IRON: PINHD-1X2; 1X02
L1: 50-100uH; SD12K100
OA1: MCP602; SO08
R1: 5.1k; 0204/5
R2, R3: 100; 0204/5
R4, R8, R18: 10k; 0204/5
R5, R10, R14: 1k; 0204/5
R6, R19: 100k; 0204/5
R7, R13: 470; 0204/5
R9: 0.11, 2W; 0204/5
R11: 500k; RJ9W
R12: 50k; 0204/5
R15, R16: 2k; 0204/5
R17: THERMISTOR; RS-2,5
SG1: EB2209A
TILT: SQ-SEN-200
U1: AT24C32A; SO08-8S1
U$1: BLUE_PILL
U$2: DISPLAY-OLED-128X64
U$3: DC-DC-STEP-DOWN; DC-DC-STEP-DOWN-MP2307
VD1: 18v; DO34Z7
VD3: 3.3v; DO34Z7
VT1: IRF9540; TO220
VT2, VT4: 2N2222; TO18
VT3: 2N2907; TO18

Connections:
+3V3: OA1.8 (V+), R15.2, R16.2, R18.2, SG1.+, U1.8 (VCC), U$1.P$20 (3.3V1), U$2.2 (VCC)
+5V: U$1.P$18 (5V), U$3.OUT+
+24V: R1.2, R19.2, U$3.IN+, VD1.C, VT1.3 (S), VT2.3 (C)
GND: C1.2, C2.2, C3.1, C4.1, C5.1, D2.A, ENCODER.4, R5.1, R9.1, R10.1, R17.1, TILT.1, U1.1 (A0), U1.2 (A1), U1.3 (A2), U1.4 (GND), U1.7 (WP), U$1.P$19 (GND2), U$1.P$21 (GND1), U$1.P$22 (GND), U$2.1 (GND), U$3.IN-, U$3.OUT-, VT3.3 (C)
unnamed: R15.1, U1.5 (SDA), U$1.P$15 (PB7)
unnamed: R16.1, U1.6 (SCL), U$1.P$14 (PB6)
unnamed: U$1.P$1 (PB12), U$2.7 (CS)
unnamed: U$1.P$25 (PB11), U$2.6 (DC)
unnamed: U$1.P$26 (PB10), U$2.5 (RES)
unnamed: U$1.P$4 (PB15), U$2.4 (D1)
unnamed: U$1.P$2 (PB13), U$2.3 (D0)
unnamed: SG1.-, U$1.P$17 (PB9)
unnamed: C5.2, ENCODER.3, U$1.P$28 (PB0)
unnamed: C4.2, ENCODER.2, U$1.P$27 (PB1)
unnamed: C3.2, ENCODER.1, U$1.P$11 (PB3)
unnamed: R11.E, R12.1
unnamed: R13.1, U$1.P$32 (PA4)
unnamed: OA1.2 (-IN), R12.2, R14.2
unnamed: OA1.3 (+IN), R4.1, VD3.C
unnamed: IRON.1, IRON.2, L1.1, R4.2, R8.2, R9.2
unnamed: D2.C, L1.2, VT1.2 (D)
unnamed: C2.1, OA1.7 (OUT), R6.1, R7.1
unnamed: OA1.6 (-IN), R6.2, R10.2
unnamed: OA1.1 (OUT), R11.A, R11.S, R13.2
unnamed: R7.2, U$1.P$34 (PA2)
unnamed: C1.1, OA1.5 (+IN), R8.1
unnamed: R2.2, R19.1, VD1.A, VT1.1 (G)
unnamed: R2.1, VT2.1 (E), VT3.1 (E)
unnamed: R1.1, VT2.2 (B), VT3.2 (B), VT4.3 (C)
unnamed: R5.2, VT4.1 (E)
unnamed: R3.2, VT4.2 (B)
unnamed: R3.1, U$1.P$36 (PA0)
unnamed: R17.2, R18.1, U$1.P$30 (PA6)
unnamed: TILT.2, U$1.P$3 (PB14)
VD3: OA1.4 (V-), R14.1, VD3.A
