sfrwmaker/hakko_t12_stm32/Inc/main.h

#define IRON_POWER_Pin GPIO_PIN_0
#define IRON_POWER_GPIO_Port GPIOA
#define IRON_CURRENT_Pin GPIO_PIN_2
#define IRON_CURRENT_GPIO_Port GPIOA
#define IRON_TEMP_Pin GPIO_PIN_4
#define IRON_TEMP_GPIO_Port GPIOA
#define AMBIENT_Pin GPIO_PIN_6
#define AMBIENT_GPIO_Port GPIOA
#define ENCODER_L_Pin GPIO_PIN_0
#define ENCODER_L_GPIO_Port GPIOB
#define ENCODER_L_EXTI_IRQn EXTI0_IRQn
#define ENCODER_B_Pin GPIO_PIN_1
#define ENCODER_B_GPIO_Port GPIOB
#define OLED_RESET_Pin GPIO_PIN_10
#define OLED_RESET_GPIO_Port GPIOB
#define OLED_DC_Pin GPIO_PIN_11
#define OLED_DC_GPIO_Port GPIOB
#define OLED_SCK_Pin GPIO_PIN_13
#define OLED_SCK_GPIO_Port GPIOB
#define OLED_SDA_Pin GPIO_PIN_15
#define OLED_SDA_GPIO_Port GPIOB
#define TILT_SW_Pin GPIO_PIN_8
#define TILT_SW_GPIO_Port GPIOA
#define OLED_CS_Pin GPIO_PIN_10
#define OLED_CS_GPIO_Port GPIOA
#define ENCODER_R_Pin GPIO_PIN_3
#define ENCODER_R_GPIO_Port GPIOB
#define BUZZER_Pin GPIO_PIN_9
#define BUZZER_GPIO_Port GPIOB
#define FW_VERSION	("3.03")
