sfrwmaker/hakko_t12_stm32/Inc/mode.h

/*
 * mode.h
 *
 *  Created on: 19 sep. 2019
 *      Author: Alex
 */

#ifndef MODE_H_
#define MODE_H_

#include "buzzer.h"
#include "core.h"
#include "oled.h"
#include "encoder.h"
#include "display.h"
#include "iron.h"
#include "cfgtypes.h"
#include "config.h"
#include "stat.h"
#include "hw.h"

class MODE  {
	public:
		MODE(HW *pCore)										{ this->pCore = pCore; }
		void			setup(MODE* return_mode, MODE* short_mode, MODE* long_mode);
		virtual void	init(void)							{ }
		virtual MODE*	loop(void)							{ return 0; }
		virtual			~MODE(void)							{ }
		MODE*			returnToMain(void);
	protected:
		void 			resetTimeout(void);
		void 			setTimeout(uint16_t t);
		HW*				pCore			= 0;
		uint16_t		timeout_secs	= 0;				// Timeout to return to main mode, seconds
		uint32_t		time_to_return 	= 0;				// Time in ms when to return to the main mode
		uint32_t		update_screen	= 0;				// Time in ms when the screen should be updated
		MODE*			mode_return		= 0;				// Previous working mode
		MODE*			mode_spress		= 0;				// When encoder button short pressed
		MODE*			mode_lpress		= 0;				// When encoder button long  pressed

};

class SCRSAVER {
	public:
		SCRSAVER(void)										{ }
		void			init(uint8_t timeout)				{ to = timeout; reset(); }
		void			reset(void);
		bool 			scrSaver(void);
	private:
		uint32_t		scr_save_ms		= 0;				// Time in ms when to switch to Screen Saver mode (if > 0)
		uint8_t			to				= 0;
		bool			scr_saver		= false;			// Is the screen saver active
};

//---------------------- The iron standby mode -----------------------------------
class MSTBY_IRON : public MODE, SCRSAVER {
	public:
		MSTBY_IRON(HW *pCore) : MODE(pCore)					{ }
		virtual void	init(void);
		virtual MODE*	loop(void);
	private:
		uint32_t		clear_used_ms	= 0;				// Time in ms when used flag should be cleared (if > 0)
		bool			used			= false;			// Whether the IRON was used (was hot)
		bool			cool_notified	= 0;				// Whether there was cold notification played
		uint16_t 		old_temp_set	= 0;
};

//-------------------- The iron main working mode, keep the temperature ----------
class MWORK_IRON : public MODE, SCRSAVER {
	public:
		MWORK_IRON(HW *pCore) : MODE(pCore), idle_pwr(ec)					{ }
		virtual void	init(void);
		virtual MODE*	loop(void);
	private:
		void 			adjustPresetTemp(void);
		void			hwTimeout(uint16_t low_temp, bool tilt_active);
		void 			swTimeout(uint16_t temp, uint16_t temp_set, uint16_t temp_setH, uint32_t td, uint32_t pd, uint16_t ap, int16_t ip);
		EMP_AVERAGE  	idle_pwr;							// Exponential average value for idle power
		bool 			auto_off_notified = false;			// The time (in ms) when the automatic power-off was notified
		bool      		ready			= false;			// Whether the IRON have reached the preset temperature
		bool			lowpower_mode	= false;			// Whether hardware low power mode using tilt switch
		uint32_t		ready_clear		= 0;				// Time when to clean 'Ready' message
		uint32_t		lowpower_time	= 0;				// Time when switch to standby power mode
		uint16_t		preset_temp		= 0;				// The preset temperature
		uint16_t 		old_temp_set	= 0;
		const uint16_t	period			= 500;				// Redraw display period (ms)
		const uint8_t	ec				= 5;				// The exponential average coefficient
};

//---------------------- The boost mode, shortly increase the temperature --------
class MBOOST : public MODE {
	public:
		MBOOST(HW *pCore) : MODE(pCore)						{ }
		virtual void	init(void);
		virtual MODE*	loop(void);
	private:
		uint16_t 		previous_temp = 0;					// Save previous IRON temperature here
		uint16_t 		old_pos 	  = 0;
};

//---------------------- The tip selection mode ----------------------------------
class MSLCT : public MODE {
	public:
		MSLCT(HW *pCore) : MODE(pCore)						{ }
		virtual void	init(void);
		virtual MODE*	loop(void);
	private:
		TIP_ITEM		tip_list[3];
		uint32_t 		tip_begin_select	= 0;			// The time in ms when we started to select new tip
		uint8_t 		old_index = 3;
};

//---------------------- The Activate tip mode: select tips to use ---------------
class MTACT : public MODE {
	public:
		MTACT(HW *pCore) : MODE(pCore)						{ }
		virtual void	init(void);
		virtual MODE*	loop(void);
	private:
		uint8_t 	old_tip_index = 255;
};


//---------------------- The Menu mode -------------------------------------------
class MMENU : public MODE {
	public:
		MMENU(HW* pCore, MODE* m_boost, MODE* m_calib, MODE* m_act, MODE* m_tune, MODE* m_pid, MODE* m_about);
		virtual void	init(void);
		virtual MODE*	loop(void);
	private:
		MODE*		mode_menu_boost;
		MODE*		mode_calibrate_menu;
		MODE*		mode_activate_tips;
		MODE*		mode_tune;
		MODE*		mode_tune_pid;
		MODE*		mode_about;
		uint8_t		off_timeout		= 0;					// Automatic switch off timeout (minutes or 0 to disable)
		uint16_t	low_temp		= 0;					// The low power temperature (Celsius or Fahrenheit) 0 - disable tilt sensor
		uint8_t		low_to			= 0;					// The low power timeout, seconds
		uint8_t		scr_saver		= 0;					// Screen saver timeout in minutes or 0 to disable
		bool		buzzer			= true;					// Whether the buzzer is enabled
		bool		celsius			= true;					// Temperature units: C/F
		bool		reed			= false;
		uint8_t		set_param		= 0;					// The index of the modifying parameter
		uint8_t		m_len			= 16;					// The menu length
		uint8_t		mode_menu_item 	= 1;					// Save active menu element index to return back later
		const char* menu_name[16] = {
			"boost setup",
			"units",
			"buzzer",
			"switch type",
			"auto off",
			"standby temp",
			"standby time",
			"screen saver",
			"save",
			"cancel",
			"calibrate tip",
			"activate tips",
			"tune",
			"reset config",
			"tune PID",
			"about"
		};
		const uint16_t	min_standby_C	= 120;				// Minimum standby temperature, Celsius
		const uint16_t	max_standby_C	= 200;				// Maximum standby temperature, Celsius
};

//---------------------- Calibrate tip menu --------------------------------------
class MCALMENU : public MODE {
	public:
		MCALMENU(HW* pCore, MODE* cal_auto, MODE* cal_manual);
		virtual void	init(void);
		virtual MODE*	loop(void);
	private:
		MODE*			mode_calibrate_tip;
		MODE*			mode_calibrate_tip_manual;
		uint8_t  		old_item = 4;
		const char* menu_list[4] = {
			"automatic",
			"manual",
			"clear",
			"exit"
		};
};

//---------------------- The calibrate tip mode: setup temperature ---------------
#define MCALIB_POINTS	8
class MCALIB : public MODE {
	public:
		MCALIB(HW *pCore) : MODE(pCore)						{ }
		virtual void	init(void);
		virtual MODE*	loop(void);
	private:
		bool 		calibrationOLS(uint16_t* tip, uint16_t min_temp, uint16_t max_temp);
		uint8_t		closestIndex(uint16_t temp);
		void 		updateReference(uint8_t indx);
		void 		buildFinishCalibration(void);
		uint8_t		ref_temp_index	= 0;					// Which temperature reference to change: [0-MCALIB_POINTS]
		uint16_t	calib_temp[2][MCALIB_POINTS];			// The calibration data: real temp. [0] and temp. in internal units [1]
		uint16_t	tip_temp_max	= 0;					// the maximum possible tip temperature in the internal units
		bool		ready			= false;				// Whether the temperature has been established
		bool		tuning			= false;
		int16_t		old_encoder 	= 3;
		const uint16_t start_int_temp = 600;				// Minimal temperature in internal units, about 100 degrees Celsius
};

//---------------------- The calibrate tip mode: manual calibration --------------
class MCALIB_MANUAL : public MODE {
	public:
		MCALIB_MANUAL(HW *pCore) : MODE(pCore)				{ }
		virtual void	init(void);
		virtual MODE*	loop(void);
	private:
		void 		buildCalibration(int8_t ablient, uint16_t tip[], uint8_t ref_point);
		uint8_t		ref_temp_index	= 0;					// Which temperature reference to change: [0-3]
		uint16_t	calib_temp[4];							// The calibration temp. in internal units in reference points
		bool		ready			= 0;					// Whether the temperature has been established
		bool		tuning			= 0;					// Whether the reference temperature is modifying (else we select new reference point)
		uint32_t	temp_setready_ms	= 0;				// The time in ms when we should check the temperature is ready
		int16_t		old_encoder 	= 4;
		uint16_t	fan_speed		= 1500;					// The Hot Air Gun fan speed during calibration
};

//---------------------- The Boost setup menu mode -------------------------------
class MMBST : public MODE {
	public:
		MMBST(HW *pCore) : MODE(pCore)						{ }
		virtual void	init(void);
		virtual MODE*	loop(void);
	private:
		uint8_t		delta_temp	= 0;						// The temperature increment
		uint8_t		duration	= 0;						// The boost period (secs)
		uint8_t		mode		= 0;						// The current mode: 0: select menu item, 1 - change temp, 2 - change duration
		uint8_t 	old_item 	= 0;
		const char* boost_name[3] = {
			"temperature",
			"duration",
			"back to menu"
		};
};


//---------------------- The tune mode -------------------------------------------
class MTUNE : public MODE {
	public:
		MTUNE(HW *pCore) : MODE(pCore)						{ }
		virtual void	init(void);
		virtual MODE*	loop(void);
	private:
		uint16_t 	old_power 		= 0;
		bool		powered   		= true;
		bool		check_connected	= false;				// Flag indicating to check IRON or Hot Air Gun is connected
		uint32_t	check_delay		= 0;					// Time in ms when to start checking Hot Air Gun is connected
};

//---------------------- The PID coefficients tune mode --------------------------
class MTPID : public MODE {
	public:
		MTPID(HW *pCore) : MODE(pCore)						{ }
		virtual void	init(void);
		virtual MODE*	loop(void);
	private:
		uint32_t	data_update	= 0;						// When read the data from the sensors (ms)
		uint32_t	temp_setready_ms	= 0;				// The time in ms when we should check the temperature is ready
		uint8_t		data_index	= 0;						// Active coefficient
		bool        modify		= 0;						// Whether is modifying value of coefficient
		bool		on			= 0;						// Whether the IRON is turned on
		uint16_t 	old_index 	= 3;
};

//---------------------- The PID coefficients automatic tune mode ----------------
class MAUTOPID : public MODE {
	public:
	typedef enum { TUNE_OFF, TUNE_HEATING, TUNE_BASE, TUNE_PLUS_POWER, TUNE_MINUS_POWER, TUNE_RELAY } TuneMode;
		MAUTOPID(HW *pCore) : MODE(pCore)					{ }
		virtual void	init(void);
		virtual MODE*	loop(void);
		bool			updatePID(void);
	private:
		uint32_t	data_update	= 0;						// When read the data from the sensors (ms)
		uint32_t	next_mode	= 0;						// When next mode can be activated (ms)
		uint16_t	base_pwr	= 0;						// The applied power when preset temperature reached
		uint16_t	base_temp	= 0;						// The temperature when base power applied
		uint16_t	delta_temp  = 0;						// The temperature limit (base_temp - delta_temp <= t <= base_temp + delta_temp)
		uint16_t	delta_power = 0;						// Extra power
		uint16_t	data_period = 250;						// Graph data update period (ms)
		TuneMode	mode		= TUNE_OFF;					// The preset temperature reached
		uint16_t	tune_loops	= 0;						// The number of oscillation loops elapsed in relay mode
		const uint16_t	max_delta_temp 		= 20;			// Maximum possible temperature difference between base_temp and upper temp.
};

//---------------------- The Fail mode: display error message --------------------
class MFAIL : public MODE {
	public:
		MFAIL(HW *pCore) : MODE(pCore)						{ }
		virtual void	init(void);
		virtual MODE*	loop(void);
};

//---------------------- The About dialog mode. Show about message ---------------
class MABOUT : public MODE {
	public:
		MABOUT(HW *pCore) : MODE(pCore)						{ }
		virtual void	init(void);
		virtual MODE*	loop(void);
};

//---------------------- The Debug mode: display internal parameters ------------
class MDEBUG : public MODE {
	public:
		MDEBUG(HW *pCore) : MODE(pCore)						{ }
		virtual void	init(void);
		virtual MODE*	loop(void);
	private:
		uint16_t		old_power 		= 0;
		const uint16_t	max_iron_power 	= 300;
};

#endif /* MODE_H_ */
